decomen/NXP-K64-gateway/README.md

# 一、概述

   DM-MK64智能物联网关是蒂蒙技术基于NXP kinetis 平台开发的产品。它采用嵌入式RT-Thread实时操作系统。
是集成了模拟信号采集、开关量输入、开关量输出、计数和 无线数据通信于一体的高性能测控装置，可以直接接入各种传感器
标准变送器信号、仪表等输 出的模拟信号、电平信号、脉冲信号等，是实施无线测控的最佳选择。

1. 开放式软件架构设计：可以提供快速灵活的定制服务，适应不同客户需求。
2. 丰富的多样化接口：提供多种接口，便于本地实时数据分析和智能化处理。
3. 工业级标准设计：具备工业级标准设计，包括宽温、防尘、防刮、防静电以及抗强电磁干扰等特性，适用于各种严苛的工业场景。
4. 稳定可靠：累计出货量已超过万台，表现稳定可靠
# 二、典型应用

物联网关在众多场景中应用广泛，典型应用场景：

1. 智慧城市排水管理系统：通过监测排水管网的状态和水位，实现智能化的排水管理，提高城市排水系统的效率和可靠性。

2. 市政供热远程监控系统：实时监测供热设备的运行状态和能耗，远程控制供热系统，提高供热效率和节能减排。

3. 智慧工厂能耗监测系统：监测工厂各项设备的能耗情况，实现能源消耗的智能管理和优化，降低能源成本。

4. 市政燃气阀室控制系统：远程监控和控制燃气阀室设备，保障城市燃气供应的安全和稳定性。

5. ###### 电站配网管理系统：监测和管理电站配电网络的运行状态，实现电力分配的智能化和优化，提高电网的稳定性和安全性。

6. 楼宇电力监测控制系统：实时监测楼宇电力设备的运行状态和用电情况，实现对楼宇电力系统的智能化管理和控制。

7. 工业污水管理控制系统：监测工业污水处理设备的运行状态和水质参数，实现对工业污水处理过程的智能化控制和优化，保障环境水质安全。 

   # 三、特性和优势  

支持 4G LTE CAT4 高速网络和 LTE CAT1、 CATM 低速网络  

支持多种联网功能  

在线编程， 二次开发  

冗余设计， 保障设备网络通信不间断  

## 强大的安全功能

全工业化设计， 无惧恶劣条件的挑战； 外露接口全部做防雷击、 防浪
涌、 防静电处理， 支持1.5KV 隔离变压保护  

### 高可靠性设计  

智能防掉线， 支持在线检测， 在线维持， 掉线自动重拨， 确保设备永远在线

  FOTA  

支持OTA在线更新， 自动在线更新软件， 支持系统升级、 系统迭代， 无
需人员维护  

# 关于我们  

     深圳市蒂蒙技术有限公司是一家专注于工业物联网领域的高科技企业，自主研发了工业物联网平台产品AIoTOS和物联网边缘侧产品EdgeOS，为5G时代万物互联提供核心的底层物联技术。作为企业构建物联中台、园开发物联网AIOT行业应用的专业合作伙伴，我们在物联网底层技术的积累与拓展中，已完成多个行业AIOT应用，包括城市智慧大脑双碳系统、工业智慧能耗系统、智能水厂生产调度系统、智慧水务监测系统、智慧工业区系统等。

联系我们

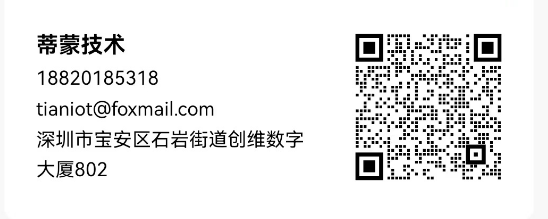
[picture p1: 小田.png]


解压密码:请扫描二维码跟客户获取。

## 目录说明

soft   源代码目录

image  烧写文件及相关工具

hardware  硬件设计源文件及生产文件

doc 相关使用文档

license.txt   BSD 3-Clause开源协议

NOTICE.md  开源声明文件

README.md   项目说明
