decomen/NXP-K64-gateway/hardware/ST-k60_coordinate.xlsx

PartType | RefDes | PartDecal | Pins | Layer | Orient. | X | Y | SMD | Glued
TESTPAD | +3V | TESET | 1 | Bottom | 0 | 31 | 98.5 | Yes | No
TESTPAD | +5V | TESET | 1 | Bottom | 0 | 19.4 | 105.4 | Yes | No
TESTPAD | +24V | TESET | 1 | Bottom | 0 | 15.2 | 2 | Yes | No
TESTPAD | -3V | TESET | 1 | Bottom | 0 | 31 | 103.5 | Yes | No
TESTPAD | -24V | TESET | 1 | Bottom | 0 | 22.8 | 2 | Yes | No
TESTPAD | 01+ | TESET | 1 | Bottom | 0 | 88.3 | 123 | Yes | No
TESTPAD | 01- | TESET | 1 | Bottom | 0 | 92.1 | 123 | Yes | No
TESTPAD | 1A | TESET | 1 | Bottom | 0 | 45.3 | 22 | Yes | No
TESTPAD | 1A_232_TX | TESET | 1 | Bottom | 0 | 47.9 | 26.8 | Yes | No
TESTPAD | 1A_485_TX | TESET | 1 | Bottom | 0 | 47.9 | 17.4 | Yes | No
TESTPAD | 1B | TESET | 1 | Bottom | 0 | 42.8 | 17.5 | Yes | No
TESTPAD | 1B_232_R | TESET | 1 | Bottom | 0 | 51.9 | 26.8 | Yes | No
TESTPAD | 1B_485_R | TESET | 1 | Bottom | 0 | 51.9 | 17.4 | Yes | No
TESTPAD | 01GND | TESET | 1 | Bottom | 0 | 54.855 | 2 | Yes | No
TESTPAD | 01RX | TESET | 1 | Bottom | 0 | 58.655 | 2 | Yes | No
TESTPAD | 01TX | TESET | 1 | Bottom | 0 | 51.045 | 2 | Yes | No
TESTPAD | 02+ | TESET | 1 | Bottom | 0 | 96 | 123 | Yes | No
TESTPAD | 02- | TESET | 1 | Bottom | 0 | 99.7 | 123 | Yes | No
TESTPAD | 2A | TESET | 1 | Bottom | 0 | 67.6 | 18.4 | Yes | No
TESTPAD | 2A_232_TX | TESET | 1 | Bottom | 0 | 55.6 | 26.8 | Yes | No
TESTPAD | 2A_485_TX | TESET | 1 | Bottom | 0 | 55.6 | 17.4 | Yes | No
TESTPAD | 2B | TESET | 1 | Bottom | 0 | 64 | 18.4 | Yes | No
TESTPAD | 2B_232_R | TESET | 1 | Bottom | 0 | 59.4 | 26.9 | Yes | No
TESTPAD | 2B_485_R | TESET | 1 | Bottom | 0 | 72.9 | 18.4 | Yes | No
TESTPAD | 02GND | TESET | 1 | Bottom | 0 | 66.285 | 2 | Yes | No
TESTPAD | 02RX | TESET | 1 | Bottom | 0 | 70.095 | 2 | Yes | No
TESTPAD | 02TX | TESET | 1 | Bottom | 0 | 62.475 | 2 | Yes | No
TESTPAD | 03+ | TESET | 1 | Bottom | 0 | 103.5 | 123 | Yes | No
TESTPAD | 03- | TESET | 1 | Bottom | 0 | 107.3 | 123 | Yes | No
TESTPAD | 3A | TESET | 1 | Bottom | 0 | 94.7 | 16 | Yes | No
TESTPAD | 03GND | TESET | 1 | Bottom | 0 | 77.715 | 2 | Yes | No
TESTPAD | 03RX | TESET | 1 | Bottom | 0 | 81.525 | 2 | Yes | No
TESTPAD | 03TX | TESET | 1 | Bottom | 0 | 73.905 | 2 | Yes | No
TESTPAD | 04+ | TESET | 1 | Bottom | 0 | 111.2 | 123 | Yes | No
TESTPAD | 04- | TESET | 1 | Bottom | 0 | 114.9 | 123 | Yes | No
TESTPAD | 4A | TESET | 1 | Bottom | 0 | 76.9 | 18.4 | Yes | No
TESTPAD | 04GND | TESET | 1 | Bottom | 0 | 89.145 | 2 | Yes | No
TESTPAD | 04RX | TESET | 1 | Bottom | 0 | 92.955 | 2 | Yes | No
TESTPAD | 04TX | TESET | 1 | Bottom | 0 | 85.335 | 2 | Yes | No
TESTPAD | 12V | TESET | 1 | Bottom | 0 | 155.6 | 106.6 | Yes | No
TESTPAD | 24+ | TESET | 1 | Bottom | 0 | 73 | 123 | Yes | No
TESTPAD | 24- | TESET | 1 | Bottom | 0 | 76.9 | 123 | Yes | No
TESTPAD | A | TESET | 1 | Bottom | 0 | 140.7 | 71.2 | Yes | No
TESTPAD | A1+ | TESET | 1 | Bottom | 0 | 120.8 | 22.1 | Yes | No
TESTPAD | A1- | TESET | 1 | Bottom | 0 | 121 | 15.2 | Yes | No
TESTPAD | A2+ | TESET | 1 | Bottom | 0 | 129 | 21.9 | Yes | No
TESTPAD | A2- | TESET | 1 | Bottom | 0 | 129 | 15.2 | Yes | No
TESTPAD | A3+ | TESET | 1 | Bottom | 0 | 136.7 | 21.8 | Yes | No
TESTPAD | A3- | TESET | 1 | Bottom | 0 | 136.8 | 15.1 | Yes | No
TESTPAD | A4+ | TESET | 1 | Bottom | 0 | 145 | 21.9 | Yes | No
TESTPAD | A4- | TESET | 1 | Bottom | 0 | 145 | 15.3 | Yes | No
TESTPAD | A5+ | TESET | 1 | Bottom | 0 | 161.5 | 22.9 | Yes | No
TESTPAD | A5- | TESET | 1 | Bottom | 0 | 152.8 | 20.6 | Yes | No
TESTPAD | A6+ | TESET | 1 | Bottom | 0 | 169.6 | 23.1 | Yes | No
TESTPAD | A6- | TESET | 1 | Bottom | 0 | 165.5 | 15.3 | Yes | No
TESTPAD | A7+ | TESET | 1 | Bottom | 0 | 177 | 22.8 | Yes | No
TESTPAD | A7- | TESET | 1 | Bottom | 0 | 173 | 15.3 | Yes | No
TESTPAD | A8+ | TESET | 1 | Bottom | 0 | 185 | 22.7 | Yes | No
TESTPAD | A8- | TESET | 1 | Bottom | 0 | 181 | 15.3 | Yes | No
TESTPAD | ADC-5V | TESET | 1 | Bottom | 0 | 150 | 45.7 | Yes | No
TESTPAD | ADC-9V | TESET | 1 | Bottom | 0 | 170.5 | 34.3 | Yes | No
TESTPAD | ADC-GND | TESET | 1 | Bottom | 0 | 145 | 45.7 | Yes | No
TESTPAD | ADC-GND1 | TESET | 1 | Bottom | 0 | 165.5 | 34.3 | Yes | No
TESTPAD | AI1+ | TESET | 1 | Bottom | 0 | 127.2 | 2 | Yes | No
TESTPAD | AI1- | TESET | 1 | Bottom | 0 | 123.4 | 2 | Yes | No
TESTPAD | AI2+ | TESET | 1 | Bottom | 0 | 134.8 | 2 | Yes | No
TESTPAD | AI2- | TESET | 1 | Bottom | 0 | 131 | 2 | Yes | No
TESTPAD | AI3+ | TESET | 1 | Bottom | 0 | 142.5 | 2 | Yes | No
TESTPAD | AI3- | TESET | 1 | Bottom | 0 | 138.6 | 2 | Yes | No
TESTPAD | AI4+ | TESET | 1 | Bottom | 0 | 150.1 | 2 | Yes | No
TESTPAD | AI4- | TESET | 1 | Bottom | 0 | 146.3 | 2 | Yes | No
TESTPAD | AI5+ | TESET | 1 | Bottom | 0 | 157.7 | 2 | Yes | No
TESTPAD | AI5- | TESET | 1 | Bottom | 0 | 153.9 | 2 | Yes | No
TESTPAD | AI6+ | TESET | 1 | Bottom | 0 | 165.3 | 2 | Yes | No
TESTPAD | AI6- | TESET | 1 | Bottom | 0 | 161.5 | 2 | Yes | No
TESTPAD | AI7+ | TESET | 1 | Bottom | 0 | 172.9 | 2 | Yes | No
TESTPAD | AI7- | TESET | 1 | Bottom | 0 | 169.2 | 2 | Yes | No
TESTPAD | AI8+ | TESET | 1 | Bottom | 0 | 180.6 | 2 | Yes | No
TESTPAD | AI8- | TESET | 1 | Bottom | 0 | 176.7 | 2 | Yes | No
TESTPAD | AT7 | TESET | 1 | Bottom | 0 | 67.6 | 45.8 | Yes | No
TESTPAD | AT8 | TESET | 1 | Bottom | 0 | 64 | 45.8 | Yes | No
KEY-2P-SMT | ATE | SW-334 | 4 | L1-Top | 270 | 1 | 51.9 | No | Yes
TESTPAD | B | TESET | 1 | Bottom | 0 | 133.7 | 71.2 | Yes | No
B0603_600_200MA_BLM18AG601SN1D_MURATA | B2 | CC0805 | 2 | L1-Top | 0 | 146.1 | 56.9 | Yes | No
CON-2P | BZ35 | CON-2P-2.0MM | 2 | L1-Top | 0 | 71 | 98.8 | No | No
CAP3 | C1 | EC-10 | 2 | L1-Top | 0 | 19 | 14 | No | No
CAP_NP | C2 | C0603 | 2 | L1-Top | 270 | 26 | 27.7 | Yes | No
CAP_NP | C3 | C0603 | 2 | L1-Top | 180 | 25.4 | 39.9 | Yes | No
CAP3 | C4 | CC0805 | 2 | L1-Top | 90 | 23.7 | 53.1 | Yes | No
CAP3 | C5 | CC0805 | 2 | L1-Top | 270 | 134.7 | 33.1 | Yes | No
CAP_NP | C6 | C0603 | 2 | L1-Top | 90 | 33.8 | 96.6 | Yes | No
CAP_NP | C7 | C0603 | 2 | L1-Top | 270 | 22.4 | 27.7 | Yes | No
C-DIP | C8 | CAP250VC | 2 | L1-Top | 90 | 3.5 | 37 | No | No
C0603_0.1UF50V_GRM188R71E104KA01D_MURATA | C9 | C0603 | 2 | L1-Top | 270 | 15.5 | 50.5 | Yes | No
CAP3 | C10 | CC0805 | 2 | L1-Top | 90 | 22.2 | 94.7 | Yes | No
CAP | C11 | C0603 | 2 | L1-Top | 90 | 22.2 | 91.2 | Yes | No
CAP3 | C12 | CC0805 | 2 | L1-Top | 270 | 33.8 | 93 | Yes | No
CAP_NP | C13 | C0603 | 2 | L1-Top | 270 | 35.7 | 93.1 | Yes | No
C-DIP | C14 | CAP250VC | 2 | L1-Top | 90 | 6.5 | 37 | No | No
RES-1/2W | C15 | R1/2W | 2 | L1-Top | 90 | 0.5 | 3 | No | No
CAP3 | C16 | CC0805 | 2 | L1-Top | 270 | 178.7 | 59.2 | Yes | No
CAP_NP | C17 | C0603 | 2 | L1-Top | 0 | 66.5 | 26.5 | Yes | No
CAP3 | C18 | CC0805 | 2 | L1-Top | 270 | 127.3 | 33.2 | Yes | No
CAP | C19 | C0603 | 2 | L1-Top | 90 | 64.3 | 53.3 | Yes | No
CAP_NP | C20 | C0603 | 2 | L1-Top | 0 | 167.1 | 28.7 | Yes | No
CAP3 | C21 | EC-7 | 2 | L1-Top | 90 | 70.9 | 47.5 | No | No
CAP3 | C22 | CC0805 | 2 | L1-Top | 90 | 60.2 | 50.2 | Yes | No
CAP_NP | C23 | C0603 | 2 | L1-Top | 270 | 60.2 | 46.6 | Yes | No
CAP3 | C24 | CC0805 | 2 | L1-Top | 270 | 62.8 | 43.6 | Yes | No
CAP_NP | C25 | C0603 | 2 | L1-Top | 270 | 65.1 | 43.8 | Yes | No
CAP_NP | C26 | C0603 | 2 | L1-Top | 0 | 136.8 | 74.8 | Yes | No
CAP | C27 | C0603 | 2 | L1-Top | 270 | 25.5 | 53.3 | Yes | No
CAP_NP | C28 | C0603 | 2 | L1-Top | 270 | 117.5 | 63.196 | Yes | No
CAP_NP | C29 | C0603 | 2 | L1-Top | 90 | 132.6 | 80.2 | Yes | No
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
CAP_NP | C198 | C0603 | 2 | L1-Top | 0 | 154.6 | 28.7 | Yes | No
CAP3 | C199 | CC0805 | 2 | L1-Top | 0 | 159.3 | 47.7 | Yes | No
CAP_NP | C206 | C0603 | 2 | L1-Top | 270 | 87.5 | 61.2 | Yes | No
CAP3 | C211 | CC0805 | 2 | L1-Top | 90 | 39 | 50.7 | Yes | No
TESTPAD | CLK | TESET | 1 | Bottom | 0 | 98.9 | 53.7 | Yes | No
CR-1220 | CR1 | CR1220 | 4 | L1-Top | 180 | 130.5 | 58.3 | No | No
BAT60A_H | D1 | 4148 | 2 | L1-Top | 90 | 48.6 | 51.3 | Yes | No
BC301N | D2 | 1812-BCXXXN-4.5X3.5X2.7MM | 2 | L1-Top | 270 | 7.5 | 4.5 | Yes | No
BF801M | D3 | BF801M | 2 | L1-Top | 0 | 2.5 | 43.5 | Yes | No
DIODE | D4 | SOD-323 | 2 | L1-Top | 180 | 129.6 | 71.6 | Yes | No
BAT60A_H | D5 | 4148 | 2 | L1-Top | 90 | 35.7 | 55 | Yes | No
BAT60A_H | D6 | 4148 | 2 | L1-Top | 90 | 42.1 | 55.1 | Yes | No
BAT60A_H | D7 | 4148 | 2 | L1-Top | 90 | 51.5 | 51.3 | Yes | No
BAT60A_H | D8 | 4148 | 2 | L1-Top | 90 | 54.6 | 49.6 | Yes | No
DIODE | D9 | SOD-323 | 2 | L1-Top | 270 | 101.6 | 45.9 | Yes | No
DIODE | D10 | SOD-323 | 2 | L1-Top | 270 | 103.6 | 45.9 | Yes | No
DIODE | D11 | SOD-323 | 2 | L1-Top | 270 | 122.9 | 99.5 | Yes | No
DIODE | D13 | SOD-323 | 2 | L1-Top | 180 | 134.1 | 42.6 | Yes | No
DIODE | D14 | SOD-323 | 2 | L1-Top | 180 | 141.6 | 42.6 | Yes | No
DIODE | D15 | SOD-323 | 2 | L1-Top | 180 | 148.8 | 42.5 | Yes | No
DIODE | D16 | SOD-323 | 2 | L1-Top | 180 | 156.2 | 42.6 | Yes | No
BAT60A_H | D17 | 4148 | 2 | L1-Top | 90 | 57.4 | 49.6 | Yes | No
BAT60A_H | D19 | 4148 | 2 | L1-Top | 180 | 37.5 | 31.5 | Yes | No
BAT60A_H | D20 | 4148 | 2 | L1-Top | 0 | 42.2 | 31.5 | Yes | No
DIODE | D22 | SOD-323 | 2 | L1-Top | 180 | 163.6 | 42.6 | Yes | No
DIODE | D23 | SOD-323 | 2 | L1-Top | 180 | 170.7 | 42.8 | Yes | No
DIODE | D24 | SOD-323 | 2 | L1-Top | 180 | 178.1 | 42.8 | Yes | No
BAT60A_H | D25 | 4148 | 2 | L1-Top | 0 | 124.8 | 67.8 | Yes | No
DIODE | D26 | SOD-323 | 2 | L1-Top | 180 | 185.5 | 42.9 | Yes | No
DIODE | D36 | SOD-323 | 2 | L1-Top | 180 | 70.8 | 95.9 | Yes | No
DIODE | D166 | SOD-323 | 2 | L1-Top | 270 | 96.9 | 101.4 | Yes | No
DIODE | D167 | SOD-323 | 2 | L1-Top | 0 | 104.9 | 95.7 | Yes | No
DIODE | D168 | SOD-323 | 2 | L1-Top | 0 | 111.9 | 95.6 | Yes | No
DIODE | D174 | SOD-323 | 2 | L1-Top | 270 | 69.4 | 113.6 | Yes | No
DIODE | D175 | SOD-323 | 2 | L1-Top | 270 | 89 | 114 | Yes | No
TESTPAD | DGND | TESET | 1 | Bottom | 0 | 94.7 | 56.2 | Yes | No
TESTPAD | DI1+ | TESET | 1 | Bottom | 0 | 123.425 | 116.5 | Yes | No
TESTPAD | DI1- | TESET | 1 | Bottom | 0 | 127.235 | 123 | Yes | No
TESTPAD | DI2+ | TESET | 1 | Bottom | 0 | 131.045 | 116.5 | Yes | No
TESTPAD | DI2- | TESET | 1 | Bottom | 0 | 134.855 | 123 | Yes | No
TESTPAD | DI3+ | TESET | 1 | Bottom | 0 | 138.7 | 116.5 | Yes | No
TESTPAD | DI3- | TESET | 1 | Bottom | 0 | 142.475 | 123 | Yes | No
TESTPAD | DI4+ | TESET | 1 | Bottom | 0 | 146.3 | 116.5 | Yes | No
TESTPAD | DI4- | TESET | 1 | Bottom | 0 | 150 | 123 | Yes | No
TESTPAD | DI5+ | TESET | 1 | Bottom | 0 | 154 | 116.5 | Yes | No
TESTPAD | DI5- | TESET | 1 | Bottom | 0 | 157.715 | 123 | Yes | No
TESTPAD | DI6+ | TESET | 1 | Bottom | 0 | 161.5 | 116.5 | Yes | No
TESTPAD | DI6- | TESET | 1 | Bottom | 0 | 165.335 | 123 | Yes | No
TESTPAD | DI7+ | TESET | 1 | Bottom | 0 | 169.3 | 116.5 | Yes | No
TESTPAD | DI7- | TESET | 1 | Bottom | 0 | 172.955 | 123 | Yes | No
TESTPAD | DI8+ | TESET | 1 | Bottom | 0 | 177 | 116.5 | Yes | No
TESTPAD | DI8- | TESET | 1 | Bottom | 0 | 180.575 | 123 | Yes | No
TESTPAD | DIO | TESET | 1 | Bottom | 0 | 94.8 | 51.2 | Yes | No
ESD | ESD1 | ESD | 2 | L1-Top | 90 | 11.5 | 4 | Yes | No
ESD | ESD2 | ESD | 2 | L1-Top | 90 | 70.1 | 2.6 | Yes | No
ESD | ESD3 | ESD | 2 | L1-Top | 90 | 62.5 | 2.6 | Yes | No
ESD | ESD4 | ESD | 2 | L1-Top | 90 | 58.7 | 2.6 | Yes | No
ESD | ESD5 | ESD | 2 | L1-Top | 90 | 51.1 | 2.6 | Yes | No
ESD | ESD6 | ESD | 2 | L1-Top | 90 | 93 | 2.7 | Yes | No
ESD | ESD7 | ESD | 2 | L1-Top | 90 | 85.3 | 2.6 | Yes | No
ESD | ESD8 | ESD | 2 | L1-Top | 90 | 81.6 | 2.6 | Yes | No
ESD | ESD9 | ESD | 2 | L1-Top | 90 | 73.9 | 2.6 | Yes | No
ESD | ESD50 | ESD | 2 | L1-Top | 270 | 127.2 | 2.4 | Yes | No
ESD | ESD51 | ESD | 2 | L1-Top | 270 | 134.85 | 2.4 | Yes | No
ESD | ESD52 | ESD | 2 | L1-Top | 270 | 142.5 | 2.4 | Yes | No
ESD | ESD53 | ESD | 2 | L1-Top | 270 | 150.15 | 2.4 | Yes | No
ESD | ESD54 | ESD | 2 | L1-Top | 90 | 123.45 | 2.4 | Yes | Yes
ESD | ESD55 | ESD | 2 | L1-Top | 90 | 131.1 | 2.4 | Yes | No
ESD | ESD56 | ESD | 2 | L1-Top | 90 | 138.75 | 2.4 | Yes | No
ESD | ESD57 | ESD | 2 | L1-Top | 90 | 146.25 | 2.4 | Yes | No
ESD | ESD58 | ESD | 2 | L1-Top | 270 | 157.65 | 2.4 | Yes | No
ESD | ESD59 | ESD | 2 | L1-Top | 270 | 165.3 | 2.4 | Yes | No
ESD | ESD60 | ESD | 2 | L1-Top | 270 | 172.95 | 2.4 | Yes | No
ESD | ESD61 | ESD | 2 | L1-Top | 270 | 180.6 | 2.4 | Yes | No
ESD | ESD62 | ESD | 2 | L1-Top | 90 | 153.9 | 2.4 | Yes | No
ESD | ESD63 | ESD | 2 | L1-Top | 90 | 161.55 | 2.4 | Yes | No
ESD | ESD64 | ESD | 2 | L1-Top | 90 | 169.2 | 2.4 | Yes | No
ESD | ESD65 | ESD | 2 | L1-Top | 90 | 176.7 | 2.4 | Yes | No
MINISMDC150 | F1 | MINISMDC150 | 2 | L1-Top | 270 | 10.5 | 29.5 | Yes | No
FU | F2 | CC0805 | 2 | L1-Top | 180 | 68.5 | 16 | Yes | No
FU | F3 | CC0805 | 2 | L1-Top | 180 | 65 | 16 | Yes | No
FU | F4 | CC0805 | 2 | L1-Top | 180 | 56 | 16 | Yes | No
FU | F5 | CC0805 | 2 | L1-Top | 180 | 47 | 16 | Yes | No
FU | F6 | CC0805 | 2 | L1-Top | 180 | 93.5 | 16 | Yes | No
FU | F7 | CC0805 | 2 | L1-Top | 180 | 84.5 | 16 | Yes | No
FUS | F8 | 2920 | 2 | L1-Top | 270 | 10.5 | 27 | Yes | No
FU | F9 | CC0805 | 2 | L1-Top | 180 | 72 | 16 | Yes | No
FU | F10 | 1206MIL | 2 | L1-Top | 90 | 72.1 | 113.6 | Yes | No
FU | F11 | 1206MIL | 2 | L1-Top | 90 | 81 | 113.6 | Yes | No
FU | F12 | CC0805 | 2 | L1-Top | 270 | 162.1 | 99.8 | Yes | No
FU | F13 | CC0805 | 2 | L1-Top | 180 | 81 | 16 | Yes | No
RES0603 | FS35 | RES0603 | 2 | L1-Top | 270 | 100.4 | 53.7 | Yes | No
TESTPAD | GND | TESET | 1 | Bottom | 0 | 15.4 | 105.4 | Yes | No
CON-3P-2.54MM | J1 | CON-3PIN-2.0MM | 3 | L1-Top | 90 | 164.4 | 108.9 | No | No
CON-3P-3.5MM | J2 | CON-3PIN-3.81MMA | 3 | L1-Top | 0 | 19 | 5.2 | No | Yes
CON-3P-2.54MM | J3 | CON-3PIN-2.0MM | 3 | L1-Top | 90 | 169.7 | 108.9 | No | No
DL | J4 | DL | 2 | L1-Top | 90 | 23.6 | 56.6 | Yes | No
DL | J5 | DL | 2 | L1-Top | 0 | 35.8 | 95.9 | Yes | No
CON-2P | J6 | CON-2P-2.0MM | 2 | L1-Top | 0 | 137.2 | 71.2 | No | No
CON-16P-3.81MM | J7 | CON-16PIN-3.81MM | 16 | L1-Top | 180 | 152 | 119.8 | No | Yes
CON-12P-3.81MM | J8 | CON-12PIN-3.81MM | 12 | L1-Top | 180 | 94 | 119.8 | No | Yes
CON-3P-2.54MM | J9 | CON-3PIN-2.0MM | 3 | L1-Top | 270 | 129.3 | 109.9 | No | No
CON-2P | J10 | CON-2P-2.0MM | 2 | L1-Top | 270 | 133 | 19 | No | No
CON-2P | J11 | CON-2P-2.0MM | 2 | L1-Top | 270 | 125 | 19 | No | No
CON-12P-3.81MM | J12 | CON-12PIN-3.81MM | 12 | L1-Top | 0 | 72 | 5.2 | No | Yes
DL | J13 | DL | 2 | L1-Top | 0 | 119.9 | 10.9 | Yes | No
DL | J14 | DL | 2 | L1-Top | 0 | 127.2 | 11 | Yes | No
DL | J15 | DL | 2 | L1-Top | 0 | 135 | 11 | Yes | No
DL | J16 | DL | 2 | L1-Top | 0 | 142.9 | 11 | Yes | No
DL | J17 | DL | 2 | L1-Top | 0 | 154 | 10.2 | Yes | No
DL | J18 | DL | 2 | L1-Top | 270 | 164.8 | 12.4 | Yes | No
DL | J19 | DL | 2 | L1-Top | 270 | 171.7 | 12.2 | Yes | No
DL | J21 | DL | 2 | L1-Top | 270 | 179.4 | 12.2 | Yes | No
CON-3P-2.54MM | J22 | CON-3PIN-2.0MM | 3 | L1-Top | 270 | 135.2 | 109.9 | No | No
CON-2P | J23 | CON-2P-2.0MM | 2 | L1-Top | 0 | 40.9 | 15.4 | No | No
CON-6P-2.54MM | J25 | BATTERY | 6 | L1-Top | 0 | -2 | 20 | No | Yes
CON-2P | J32 | CON-2P-2.0MM | 2 | L1-Top | 270 | 121 | 19 | No | No
CON-2P | J33 | CON-2P-2.0MM | 2 | L1-Top | 180 | 40.9 | 11.7 | No | No
CON-2P | J35 | CON-2P-2.0MM | 2 | L1-Top | 0 | 94.4 | 19 | No | No
SD_CARD_2 | J36 | SD | 14 | Bottom | 180 | 52.8 | 91.5 | No | Yes
RJ45-LED-PT | J37 | RJ45-LED-PT | 16 | L1-Top | 0 | 108 | 2.6 | No | No
CON-2P | J38 | CON-2P-2.0MM | 2 | L1-Top | 180 | 94.4 | 23.7 | No | No
CON-3P-2.54MM | J39 | CON-3PIN-2.0MM | 3 | L1-Top | 270 | 55.6 | 22.1 | No | No
CON-3P-2.54MM | J40 | CON-3PIN-2.0MM | 3 | L1-Top | 270 | 59.4 | 22.2 | No | No
CON-3P-2.54MM | J41 | CON-3PIN-2.0MM | 3 | L1-Top | 270 | 47.9 | 22.1 | No | No
CON-3P-2.54MM | J42 | CON-3PIN-2.0MM | 3 | L1-Top | 270 | 51.9 | 22.1 | No | No
CON-16P-3.81MM | J45 | CON-16PIN-3.81MM | 16 | L1-Top | 0 | 152 | 5.2 | No | Yes
DL | J49 | DL | 2 | L1-Top | 180 | 103.8 | 43 | Yes | No
CON-2P | J52 | CON-2P-2.0MM | 2 | L1-Top | 270 | 129 | 19 | No | No
CON-2P | J53 | CON-2P-2.0MM | 2 | L1-Top | 270 | 141 | 19 | No | No
CON-2P | J54 | CON-2P-2.0MM | 2 | L1-Top | 270 | 137 | 19 | No | No
CON-2P | J55 | CON-2P-2.0MM | 2 | L1-Top | 270 | 149 | 19 | No | No
CON-2P | J56 | CON-2P-2.0MM | 2 | L1-Top | 270 | 145 | 19 | No | No
CON-2P | J57 | CON-2P-2.0MM | 2 | L1-Top | 270 | 161.5 | 19 | No | No
CON-2P | J58 | CON-2P-2.0MM | 2 | L1-Top | 180 | 155.8 | 20.6 | No | No
CON-2P | J59 | CON-2P-2.0MM | 2 | L1-Top | 270 | 169 | 19 | No | No
CON-2P | J60 | CON-2P-2.0MM | 2 | L1-Top | 270 | 165.5 | 19 | No | No
CON-2P | J61 | CON-2P-2.0MM | 2 | L1-Top | 270 | 177 | 19 | No | No
CON-2P | J62 | CON-2P-2.0MM | 2 | L1-Top | 270 | 173 | 19 | No | No
CON-2P | J63 | CON-2P-2.0MM | 2 | L1-Top | 270 | 185 | 19 | No | No
CON-2P | J64 | CON-2P-2.0MM | 2 | L1-Top | 270 | 181 | 19 | No | No
CON-4PIN-2.54MM | JTAG | CON-4PIN-2.54MM | 4 | L1-Top | 270 | 96.7 | 52.5 | No | No
L-SMD-4P | L1 | L-SMD-4P | 4 | L1-Top | 0 | 18.5 | 23 | Yes | No
INDUCTOR | L2 | L-7X7X3.2MM | 2 | L1-Top | 0 | 25.1 | 46.2 | Yes | No
INDUCTOR1 | L3 | 0805 | 2 | L1-Top | 0 | 171.1 | 57.9 | Yes | No
INDUCTOR | L4 | L0805 | 2 | L1-Top | 180 | 109.2 | 42.7 | Yes | No
INDUCTOR | L5 | L0805 | 2 | L1-Top | 0 | 113.1 | 59.2 | Yes | No
INDUCTOR | L6 | L0805 | 2 | L1-Top | 270 | 119.5 | 39.9 | Yes | No
INDUCTOR | L7 | L0805 | 2 | L1-Top | 270 | 149.7 | 107.4 | Yes | No
INDUCTOR1 | L8 | 0805 | 2 | L1-Top | 180 | 23.6 | 56.6 | Yes | No
INDUCTOR1 | L9 | 0805 | 2 | L1-Top | 0 | 56.9 | 30.5 | Yes | No
INDUCTOR1 | L10 | 0805 | 2 | L1-Top | 0 | 167 | 62.3 | Yes | No
INDUCTOR1 | L11 | 0805 | 2 | L1-Top | 0 | 169.1 | 57.9 | Yes | No
INDUCTOR | L13 | L0805 | 2 | L1-Top | 0 | 118.8 | 5.4 | Yes | No
XC434 | L14 | SDCW2012A | 4 | L1-Top | 0 | 65.5 | 20 | Yes | No
XC434 | L15 | SDCW2012A | 4 | L1-Top | 0 | 86.9 | 20 | Yes | No
XC434 | L16 | SDCW2012A | 4 | L1-Top | 0 | 79.9 | 20 | Yes | No
INDUCTOR1 | L17 | 0805 | 2 | L1-Top | 0 | 93.7 | 40.8 | Yes | No
INDUCTOR1 | L18 | 0805 | 2 | L1-Top | 0 | 59 | 30.4 | Yes | No
INDUCTOR1 | L19 | 0805 | 2 | L1-Top | 0 | 54.2 | 30.4 | Yes | No
INDUCTOR1 | L20 | 0805 | 2 | L1-Top | 0 | 48.2 | 30.4 | Yes | No
INDUCTOR1 | L21 | 0805 | 2 | L1-Top | 0 | 91.5 | 40.8 | Yes | No
ER-081SG | L30 | ER-081SG | 8 | L1-Top | 270 | 39 | 40.8 | Yes | No
INDUCTOR1 | L38 | 0805 | 2 | L1-Top | 90 | 74.8 | 71 | Yes | No
INDUCTOR | L54 | L0805 | 2 | L1-Top | 0 | 173 | 53 | Yes | No
INDUCTOR1 | L112 | 0805 | 2 | L1-Top | 180 | 45.9 | 9.7 | Yes | No
XC434 | L127 | SDCW2012A | 4 | L1-Top | 0 | 72.4 | 20 | Yes | No
TLED | LED | TLED | 6 | L1-Top | 90 | 30.27 | 1 | No | Yes
MRK | MR1 | MRK | 1 | Bottom | 0 | 7 | 10 | Yes | No
MRK | MR2 | MRK | 1 | L1-Top | 0 | 7 | 10 | Yes | No
MRK | MR3 | MRK | 1 | L1-Top | 0 | 178.4 | 114.2 | Yes | No
MRK | MR4 | MRK | 1 | Bottom | 0 | 178.4 | 114.2 | Yes | No
VIA | P1 | VIA3.0MM | 9 | L1-Top | 0 | 7 | 16.1 | No | No
TESTPAD | PE-GND | TESET | 1 | Bottom | 0 | 19 | 2 | Yes | No
PMOS_1 | Q1 | SOP-8 | 8 | L1-Top | 180 | 19.2 | 55.6 | Yes | No
P-MOS | Q2 | SOT23 | 3 | L1-Top | 90 | 83.3 | 59.2 | Yes | No
2N3904_0 | Q3 | SOT23 | 3 | L1-Top | 0 | 72.4 | 56.5 | Yes | No
2N3904_0 | Q6 | SOT23 | 3 | L1-Top | 90 | 127.6 | 99.6 | Yes | No
2N3904_0 | Q7 | SOT23 | 3 | L1-Top | 270 | 165.4 | 86.8 | Yes | No
P-MOS-6 | Q9 | SOT-23-6 | 6 | L1-Top | 90 | 165.8 | 81.8 | Yes | No
2N3904_0 | Q12 | SOT23 | 3 | L1-Top | 270 | 74.3 | 38.3 | Yes | No
2N3904_0 | Q13 | SOT23 | 3 | L1-Top | 270 | 67 | 38.4 | Yes | No
2N3904_0 | Q16 | SOT23 | 3 | L1-Top | 90 | 88.4 | 58.1 | Yes | No
2N3904_0 | Q17 | SOT23 | 3 | L1-Top | 270 | 88.6 | 38.1 | Yes | No
2N3904_0 | Q19 | SOT23 | 3 | L1-Top | 270 | 81.2 | 38.2 | Yes | No
2N3906 | Q38 | SOT23 | 3 | L1-Top | 90 | 70.3 | 93.5 | Yes | No
2N3904_0 | Q39 | SOT23 | 3 | L1-Top | 90 | 77.1 | 93.5 | Yes | No
2N3904_0 | Q50 | SOT23 | 3 | L1-Top | 0 | 67.1 | 56.5 | Yes | No
2N3904_0 | Q166 | SOT23 | 3 | L1-Top | 0 | 94.2 | 104.6 | Yes | No
2N3904_0 | Q167 | SOT23 | 3 | L1-Top | 90 | 108.1 | 93.9 | Yes | No
2N3904_0 | Q168 | SOT23 | 3 | L1-Top | 90 | 115.7 | 94.8 | Yes | No
2N3904_0 | Q169 | SOT23 | 3 | L1-Top | 0 | 78.1 | 103.4 | Yes | No
2N3904_0 | Q170 | SOT23 | 3 | L1-Top | 0 | 87 | 103.3 | Yes | No
RES | R1 | R0603 | 2 | L1-Top | 90 | 29.4 | 27.6 | Yes | No
RES | R2 | R0603 | 2 | L1-Top | 90 | 24.2 | 27.7 | Yes | No
RES | R3 | R0603 | 2 | L1-Top | 90 | 18.8 | 31 | Yes | No
RES | R4 | R0603 | 2 | L1-Top | 180 | 22.2 | 39.9 | Yes | No
MOV14D15V | R5 | 1206MIL | 2 | L1-Top | 90 | 0.5 | 36.5 | Yes | No
RES | R6 | R0603 | 2 | L1-Top | 270 | 18.8 | 27.7 | Yes | No
MOV14D15V | R7 | 1206MIL | 2 | L1-Top | 90 | 10 | 36.5 | Yes | No
RES1 | R8 | R0603 | 2 | L1-Top | 90 | 13.7 | 47.2 | Yes | No
RES | R9 | R0603 | 2 | L1-Top | 90 | 20.6 | 27.7 | Yes | No
RES1 | R10 | R0603 | 2 | L1-Top | 270 | 13.7 | 44 | Yes | No
RES1 | R11 | R0603 | 2 | L1-Top | 270 | 15.5 | 53.7 | Yes | No
RES | R12 | R0603 | 2 | L1-Top | 0 | 4.2 | 69 | Yes | No
R0603 | R13 | R0603 | 2 | L1-Top | 0 | 129.8 | 79.2 | Yes | No
R0603 | R14 | R0603 | 2 | L1-Top | 90 | 134.5 | 80.2 | Yes | No
R0603 | R15 | R0603 | 2 | L1-Top | 270 | 136.3 | 80.2 | Yes | No
R0603 | R16 | R0603 | 2 | L1-Top | 90 | 123.3 | 73.7 | Yes | No
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
RES | R238 | R0603 | 2 | L1-Top | 90 | 184.8 | 24.7 | Yes | No
R0603 | R241 | R0603 | 2 | L1-Top | 90 | 123.3 | 77 | Yes | No
RES | R242 | R0603 | 2 | L1-Top | 270 | 127.2 | 87 | Yes | No
RES | R243 | R0603 | 2 | L1-Top | 90 | 181.3 | 24.7 | Yes | No
R0603_33_1%_ERJ-3GEYJ220V_PANASONIC | R246 | R0603 | 2 | L1-Top | 90 | 155 | 61.2 | Yes | No
RES | R248 | R0603 | 2 | L1-Top | 270 | 27.2 | 59.8 | Yes | No
RES | R250 | R0603 | 2 | L1-Top | 90 | 91.5 | 57.9 | Yes | No
RES | R251 | R0603 | 2 | L1-Top | 0 | 85 | 56.7 | Yes | No
RES | R252 | R0603 | 2 | L1-Top | 270 | 85.8 | 59 | Yes | No
RES | R253 | R0603 | 2 | L1-Top | 0 | 185.5 | 27 | Yes | No
RES | R254 | R0603 | 2 | L1-Top | 0 | 182.3 | 27 | Yes | No
RES | R255 | R0603 | 2 | L1-Top | 180 | 185.3 | 40.9 | Yes | No
RES | R256 | R0603 | 2 | L1-Top | 180 | 182.2 | 40.9 | Yes | No
RES | R257 | R0603 | 2 | L1-Top | 180 | 185.3 | 39.2 | Yes | No
R-1206 | R258 | R-1206 | 2 | L1-Top | 90 | 184.5 | 12.5 | Yes | No
R-1206 | R259 | R-1206 | 2 | L1-Top | 90 | 181.5 | 12.5 | Yes | No
R0603 | R260 | R0603 | 2 | L1-Top | 270 | 64.3 | 56.4 | Yes | No
R0603 | R261 | R0603 | 2 | L1-Top | 270 | 66.2 | 53.4 | Yes | No
R0603 | R262 | R0603 | 2 | L1-Top | 270 | 64 | 69.5 | Yes | No
R0603 | R263 | R0603 | 2 | L1-Top | 90 | 68 | 53.4 | Yes | No
R0603 | R266 | R0603 | 2 | L1-Top | 270 | 69.8 | 56.5 | Yes | No
RES | R268 | R0603 | 2 | L1-Top | 270 | 100.5 | 93.2 | Yes | No
RES | R269 | R0603 | 2 | L1-Top | 270 | 85.5 | 93.3 | Yes | No
R0603_33_1%_ERJ-3GEYJ220V_PANASONIC | R270 | R0603 | 2 | L1-Top | 90 | 151.3 | 61.2 | Yes | No
R0603_33_1%_ERJ-3GEYJ220V_PANASONIC | R271 | R0603 | 2 | L1-Top | 90 | 156.8 | 61.2 | Yes | No
RES | R281 | R0603 | 2 | L1-Top | 0 | 165.4 | 84.3 | Yes | No
RES | R282 | R0603 | 2 | L1-Top | 180 | 162.2 | 84.3 | Yes | No
R0603 | R284 | R0603 | 2 | L1-Top | 270 | 73.2 | 53.4 | Yes | No
R0603 | R285 | R0603 | 2 | L1-Top | 270 | 69.7 | 69.5 | Yes | No
R0603 | R286 | R0603 | 2 | L1-Top | 90 | 71.5 | 53.4 | Yes | No
KEY-2P-SMT | RESET1 | SW-334 | 4 | L1-Top | 0 | 39.5 | 4 | No | Yes
DIODE_TVS_BIDIR | S7 | SOD-323 | 2 | L1-Top | 270 | 52.3 | 30.3 | Yes | No
DIODE_TVS_BIDIR | S8 | SOD-323 | 2 | L1-Top | 270 | 50.4 | 30.3 | Yes | No
DIODE_TVS_BIDIR | S9 | SOD-323 | 2 | L1-Top | 180 | 56.2 | 33.1 | Yes | No
DIODE_TVS_BIDIR | S10 | SOD-323 | 2 | L1-Top | 0 | 59.8 | 33.1 | Yes | No
RELAY | SC1 | PA-RELAY | 4 | L1-Top | 90 | 117.9 | 105.8 | No | No
RELAY | SC166 | PA-RELAY | 4 | L1-Top | 90 | 100.3 | 105.7 | No | No
RELAY | SC167 | PA-RELAY | 4 | L1-Top | 90 | 106.1 | 105.7 | No | No
RELAY | SC168 | PA-RELAY | 4 | L1-Top | 90 | 112.1 | 105.7 | No | No
AQY212EH | SC169 | AQY212EH | 4 | L1-Top | 90 | 76.7 | 111.6 | Yes | No
AQY212EH | SC170 | AQY212EH | 4 | L1-Top | 90 | 85.5 | 111.6 | Yes | No
P0080SC | T1 | SMB-DO-214AA | 2 | L1-Top | 90 | 68 | 10.8 | Yes | No
P0080SC | T2 | SMB-DO-214AA | 2 | L1-Top | 90 | 62.5 | 10.8 | Yes | No
P0080SC | T3 | SMB-DO-214AA | 2 | L1-Top | 90 | 56 | 10.7 | Yes | No
P0080SC | T4 | SMB-DO-214AA | 2 | L1-Top | 90 | 51 | 10.7 | Yes | No
P0080SC | T5 | SMB-DO-214AA | 2 | L1-Top | 90 | 92.4 | 10.9 | Yes | No
P0080SC | T6 | SMB-DO-214AA | 2 | L1-Top | 90 | 87.5 | 10.9 | Yes | No
P0080SC | T7 | SMB-DO-214AA | 2 | L1-Top | 90 | 79.5 | 10.9 | Yes | No
P0080SC | T8 | SMB-DO-214AA | 2 | L1-Top | 90 | 74.7 | 10.9 | Yes | No
P0080SC | T9 | SMB-DO-214AA | 2 | L1-Top | 90 | 115.6 | 19.6 | Yes | No
P0080SC | T10 | SMB-DO-214AA | 2 | L1-Top | 90 | 110.4 | 19.6 | Yes | No
P0080SC | T11 | SMB-DO-214AA | 2 | L1-Top | 90 | 105.4 | 19.6 | Yes | No
P0080SC | T12 | SMB-DO-214AA | 2 | L1-Top | 90 | 100.4 | 19.6 | Yes | No
H1102 | T201 | H1102 | 16 | L1-Top | 180 | 115 | 38.1 | Yes | No
TESTPAD | TTL1 | TESET | 1 | Bottom | 0 | 80.7 | 123 | Yes | No
TESTPAD | TTL2 | TESET | 1 | Bottom | 0 | 84.5 | 123 | Yes | No
DIODE_TVS_BIDIR | TVS2 | SOD-323 | 2 | L1-Top | 270 | 62.6 | 21.8 | Yes | No
DIODE_TVS_BIDIR | TVS3 | SOD-323 | 2 | L1-Top | 270 | 68 | 21.8 | Yes | No
DIODE_TVS_BIDIR | TVS4 | SOD-323 | 2 | L1-Top | 180 | 65.3 | 23.3 | Yes | No
DIODE_TVS_BIDIR | TVS5 | SOD-323 | 2 | L1-Top | 270 | 84.3 | 22 | Yes | No
DIODE_TVS_BIDIR | TVS6 | SOD-323 | 2 | L1-Top | 270 | 89.5 | 22 | Yes | No
DIODE_TVS_BIDIR | TVS7 | SOD-323 | 2 | L1-Top | 180 | 86.8 | 23.3 | Yes | No
DIODE_TVS_BIDIR | TVS8 | SOD-323 | 2 | L1-Top | 270 | 77 | 21.9 | Yes | No
DIODE_TVS_BIDIR | TVS10 | SOD-323 | 2 | L1-Top | 270 | 82.2 | 22 | Yes | No
DIODE_TVS_BIDIR | TVS11 | SOD-323 | 2 | L1-Top | 180 | 79.6 | 23.3 | Yes | No
DIODE_TVS_BIDIR | TVS124 | SOD-323 | 2 | L1-Top | 270 | 75 | 21.9 | Yes | No
DIODE_TVS_BIDIR | TVS127 | SOD-323 | 2 | L1-Top | 270 | 69.8 | 21.8 | Yes | No
DIODE_TVS_BIDIR | TVS128 | SOD-323 | 2 | L1-Top | 180 | 72.4 | 23.3 | Yes | No
RT7272B | U1 | SOP-8A | 9 | L1-Top | 180 | 24.1 | 34.2 | Yes | No
TL431 | U2 | SOT89 | 3 | L1-Top | 270 | 8.9 | 47.3 | Yes | No
AM1117-3.3V | U3 | SOT223 | 4 | L1-Top | 270 | 27.9 | 94.2 | Yes | No
UA258 | U4 | SOP-8 | 8 | L1-Top | 180 | 9.9 | 55.5 | Yes | No
B0505M-1W | U5 | B0505M-1W | 4 | L1-Top | 0 | 31.5 | 14 | No | No
XC6XXX-89 | U6 | SOT89 | 3 | L1-Top | 90 | 65 | 48.3 | Yes | No
SN74LVC1G04 | U7 | SOT25-2 | 5 | L1-Top | 180 | 130.1 | 82.7 | Yes | No
AM1117-3.3V | U8 | SOT223 | 4 | L1-Top | 270 | 16.5 | 94.2 | Yes | No
LM358 | U9 | SOP-8 | 8 | L1-Top | 0 | 138.4 | 33.9 | Yes | No
KSZ8081RNACA | U10 | QFN-32PIN-4X4MM | 25 | L1-Top | 90 | 113.6 | 49.3 | Yes | No
MAX813L | U11 | SOP-8 | 8 | L1-Top | 90 | 129.7 | 75.4 | Yes | No
B0524-1W | U12 | B0524-1W | 4 | L1-Top | 0 | 168.7 | 70.2 | No | No
OPTOISO1 | U13 | LTV357 | 4 | L1-Top | 90 | 71 | 62.9 | Yes | No
SP485 | U14 | SOP-8 | 8 | L1-Top | 180 | 64.8 | 32.2 | Yes | No
SP485 | U15 | SOP-8 | 8 | L1-Top | 180 | 86.8 | 31.8 | Yes | No
SP485 | U16 | SOP-8 | 8 | L1-Top | 180 | 79.5 | 31.8 | Yes | No
RT9077-90 | U17 | SOT25-2 | 5 | L1-Top | 0 | 184.9 | 64.4 | Yes | No
TTL-RF | U18 | TTL-RF | 12 | L1-Top | 180 | 161.5 | 115.5 | No | No
XC6XXX-89 | U19 | SOT89 | 3 | L1-Top | 0 | 175 | 60.6 | Yes | No
LM358 | U20 | SOP-8 | 8 | L1-Top | 0 | 145.7 | 33.8 | Yes | No
LM358 | U21 | SOP-8 | 8 | L1-Top | 0 | 153.1 | 33.7 | Yes | No
TTL-RF | U22 | TTL-RF | 12 | L1-Top | 180 | 186 | 103 | No | No
SPI-SRAM | U23 | SOP-8 | 8 | L1-Top | 90 | 121 | 83.1 | Yes | No
LM358 | U24 | SOP-8 | 8 | L1-Top | 0 | 160.7 | 33.7 | Yes | No
LM358 | U26 | SOP-8 | 8 | L1-Top | 0 | 168.3 | 33.6 | Yes | No
LM358 | U27 | SOP-8 | 8 | L1-Top | 0 | 176 | 33.6 | Yes | No
LM358 | U28 | SOP-8 | 8 | L1-Top | 0 | 183.5 | 33.5 | Yes | No
IC_AD7689_8CH16B250K_ADC_ADI | U29 | AD7689 | 21 | L1-Top | 90 | 154.9 | 52.3 | Yes | No
RTU-EXPANSION | U30 | RTU_EXPANSION | 48 | L1-Top | 0 | -2 | 75 | No | No
K60_144P | U36 | LQFP-144PIN-22X22MM | 144 | L1-Top | 0 | 95 | 77 | Yes | No
SOP-8 | U37 | TQFN-8 | 8 | L1-Top | 0 | 119.8 | 89.7 | Yes | No
SN6501 | U38 | SOT25-2 | 5 | L1-Top | 180 | 38.8 | 56.2 | Yes | No
LM358 | U52 | SOP-8 | 8 | L1-Top | 0 | 130.8 | 34 | Yes | No
REF19X | U56 | SOP-8 | 8 | L1-Top | 180 | 169 | 50.5 | Yes | No
OPTOISO1 | U58 | LTV357 | 4 | L1-Top | 90 | 65 | 62.9 | Yes | No
ADUM1411 | U59 | SOIC127P1030X265-16N | 16 | L1-Top | 270 | 154 | 73 | Yes | No
NUP4301 | U63 | TSOP-6 | 6 | L1-Top | 0 | 113.9 | 42.5 | Yes | No
SP232E | U115 | SO16NB | 16 | L1-Top | 0 | 52.8 | 40.6 | Yes | No
SP485 | U120 | SOP-8 | 8 | L1-Top | 180 | 72.3 | 31.8 | Yes | No
ADUM1402 | U124 | SOIC127P1030X265-16N | 16 | L1-Top | 270 | 54.7 | 62.6 | Yes | No
ADUM1402 | U125 | SOIC127P1030X265-16N | 16 | L1-Top | 270 | 84.7 | 46.7 | Yes | No
TESTPAD | VCC | TESET | 1 | Bottom | 0 | 124.5 | 110.9 | Yes | No
TESTPAD | VCC1 | TESET | 1 | Bottom | 0 | 177.4 | 97.2 | Yes | No
TESTPAD | VCC2 | TESET | 1 | Bottom | 0 | 167 | 108.9 | Yes | No
TESTPAD | VCC_DET | TESET | 1 | Bottom | 0 | 96.7 | 46.6 | Yes | No
CRYSTAL_JXS63 | Y1 | OSC-49S | 4 | L1-Top | 90 | 123.8 | 45.8 | Yes | No
OSC-32.768K | Y2 | OSC-49S | 4 | L1-Top | 180 | 115.9 | 67 | Yes | No
OSC-32.768K | Y36 | OSC-49S | 4 | L1-Top | 0 | 79.3 | 63 | Yes | No
