decomen/NXP-K64-gateway/hardware/ST-k60_BOM.xlsx

K60_4.0 2017/12/19 565套
Index | Part Number | Description | Decal | QTY | Name | Remarks
1 | SPI SRAM | 23LCV1024 | SOP-8 | 1 | U23 | NC
2 | 电源模块 | ZME1205S/D | ZME1205-1W | 1 | U5 | NC
8 | 电源模块 | ZM2H1212SA/DA | ZM2H1212-2W | 1 | U12
3 | 通信模块排座 | 扩展模块 | 双排24PINX2/2.0MM | 2 | U30
4 | 输入模块 | 输入模块 | TTL-RF | 2 | U18 U22
5 | 模数转换器 | AD7689BCPZ | QFN-20 | 1 | U29
6 | 磁耦芯片 | ADUM1411ARWZ | SOIC-16N | 1 | U59
7 | 磁耦芯片 | ADUM1412ARWZ/ISO7242CDWR | SOIC-16N | 2 | U124 U125
8 | 普通光耦 | LTV-357T-C | LTV357 | 2 | U13 U58
9 | 网口芯片 | KSZ8081RNACA | QFN-32PIN | 1 | U10
10 | 双运放 | LM358 | SOP-8 | 1 | U4 | NC
11 | 双运放 | TP2272-SR | SOP-8 | 8 | U9 U20 U21 U24 U26 U27 U28 U52
12 | 主控芯片 | MK64FN1M0VLQ12 | LQFP-144 | 1 | U36
13 | 微控芯片 | SP706REN | SOP-8 | 1 | U11
14 | 基准芯片 | REF195GSZ-REEL7 | SOP-8 | 1 | U56
15 | ESD芯片 | NUP4301MR6T1G | TSOP-6 | 1 | U63
16 | 存储芯片 | W25Q256FVEM | WSON-8 | 1 | U37
17 | 电源芯片 | RT7272BGSP | SOP-8 | 1 | U1
18 |  | RT9161A-50PX | SOT89 | 2 | U6 U19
19 |  | NCP1117ST33T3G | SOT223 | 1 | U3
 |  | NCP1117ST50T3G | SOT223 | 1 | U8
20 |  | SPX3819M5-ADJ | SOT25-2 | 1 | U17
21 | 可控精密稳压源 | TL431 | SOT89 | 0 | U2 | NC
22 | 单路反向器 | SN74LVC1G04 | SOT23-5 | 0 | U7 | NC
 | 震荡芯片 | SN6501DBVR | SOT23-5 | 1 | U38
23 | 通信芯片 | SP232EEN-L/TR | SO16NB | 1 | U115
24 |  | BL3085N | SOP-8 | 4 | U14 U15 U16 U120
25 | 普通二极管 | 1N4148WS-7-F | SOD-323 | 17 | D4 D9 D10 D13 D14 D15 D16 D22 D23 D24 D26 D11 D166 D167 D168 D174 D175
26 | 普通二极管 | 1N5819HW-7-F | SOD-123 | 9 | D1 D5 D6 D7 D8 D17 D19 D20 D25
27 | P-MOS管 | AO4407 | SOP-8 | 0 | Q1 | NC
28 |  | AO6405 | SOT-23-6 | 1 | Q9
29 |  | Si2399DS-T1-GE3 | SOT23 | 1 | Q2
30 | NPN三极管 | MMBT3904LT1G | SOT23 | 14 | Q3 Q6 Q7 Q12 Q13 Q16 Q17 Q19 Q50 Q166 Q167 Q168 Q169 Q170
31 | SD卡 | AXA2R73061 | SD | 1 | J36
32 | 有源晶体 | 25MHZ | 5032 | 1 | Y2
33 | 有源晶体 | 32.768K/有源晶体 | 5032 | 1 | Y36
34 | 电池座 | 纽扣电池座 | CR1220 | 1 | CR1
35 | 气体放电管 | BF801M/SG5042B800 | 1812 | 1 | D3
36 |  | SMD301X/SMD300XM | 1812 | 1 | D2
37 | 半导体放电管 | SELC15CI | SOD-323 | 4 | S7 S8 S9 S10
38 |  | SELC08CI | SOD-323 | 12 | TVS2 TVS3 TVS4 TVS5 TVS6 TVS7 TVS8 TVS10 TVS11 TVS124 TVS127 TVS128
39 |  | P0300SC | SMB-DO-214AA | 8 | T1 T2 T3 T4 T5 T6 T7 T8
40 |  | P4200SC | SMB-DO-214AA | 4 | T9 T10 T11 T12
41 | 磁珠 | CBW201209U101T | 0805 | 13 | L3 L4 L5 L6 L7 L10 L11 L17 L21 L38 L54 L112 B2 | L8(NC)
42 |  | CBW201209U121T | 0805 | 4 | L9 L18 L19 L20
43 | 自恢复保险丝 | Z-MSMD110 | 1812 | 1 | F1
44 |  | MF-PSMF010X-2 | 0805 | 9 | F2 F3 F4 F5 F6 F7 F9 F13 F12
45 |  | MF-NSMF050-2 | 1206 | 2 | F10 F11
47 | 共模电感 | ILS0405-01 | SMD-4 | 1 | L1
48 |  | WCM-3216-222T | SOD-4 | 4 | L14 L15 L16 L127
49 | 功率电感 | SLF7045T-100M1R0-PF | 7X7MM | 1 | L2
50 | 隔离电感 | ER-081SG | 10X10MM | 1 | L30
51 | 压敏电阻 | KRMV1206G330NXT | 1206 | 2 | R5 R7 | R172(NC)
52 | 网络变压器 | H1601G | SOIC-16 | 1 | T201
53 | 贴片电阻 | 0R | R0603 | 4 | R45 R147 R148 FS35
53 | 贴片电阻 | 22R | R0603 | 24 | R12 R31 R32 R33 R34 R35 R36 R37 R38 R39 R58 R59 R60 R61 R62 R63 R64 R79 R155 R221 R228 R246 R270 R271
54 | 贴片电阻 | 49.9R | R0603 | 8 | R65 R66 R96 R140 R141 R144 R145 R146
55 | 贴片电阻 | 75R | R0603 | 4 | R125 R128 R129 R130
56 | 圆柱贴片电阻 | 100R | 1206 | 16 | R19 R24 R103 R136 R180 R182 R190 R191 R199 R200 R208 R214 R236 R237 R258 R259
57 | 贴片电阻 | 120R | 1206 | 4 | R104 R105 R106 R107 | R26(NC)
58 | 贴片电阻 | 100R | R0603 | 4 | R150 R167 R169 R171
60 | 贴片电阻 | 330R | R0603 | 13 | R17 R69 R70 R102 R134 R152 R154 R158 R159 R160 R161 R173 R176
61 | 贴片电阻 | 715R | R0603 | 8 | R68 R98 R108 R109 R113 R114 R123 R126
62 | 贴片电阻 | 1K | R0603 | 15 | R51 R100 R111 R116 R266 R260 R261 R282 R284 R174 R177 R151 R166 R168 R170
63 | 贴片电阻 | 3.3K | R0603 | 5 | R6 R16 R20 R138 R250
64 | 贴片电阻 | 6.49K | R0603 | 1 | R44
65 | 贴片电阻 | 10K | R0603 | 28 | R11 R27 R28 R42 R43 R48 R54 R55 R56 R57 R67 R72 R73 R76 R90 R95 R101 R112 R119 R124 R132 R156 R251 R262 R268 R269 R285 | R14(NC)
66 | 贴片电阻 | 13K | R0603 | 0 |  | R10(NC)
67 | 贴片电阻 | 15K | R0603 | 2 | R4 R122
68 | 贴片电阻 | 18K | R0603 | 0 |  | R8(NC)
69 | 贴片电阻 | 20K | R0603 | 8 | R52 R120 R175 R187 R196 R205 R233 R255
70 | 贴片电阻 | 30K | R0603 | 48 | R29 R30 R41 R47 R49 R50 R53 R92 R93 R97 R121 R131 R137 R139 R149 R153 R178 R179 R183 R184 R185 R186 R188 R189 R192 R193 R194 R195 R197 R198 R201 R202 R203 R204 R206 R207 R222 R230 R231 R232 R234 R235 R238 R243 R253 R254 R256 R257
71 | 贴片电阻 | 33K | R0603 | 1 | R9
72 | 贴片电阻 | 47K | R0603 | 4 | R3 R21 R18 R94
73 | 贴片电阻 | 56K | R0603 | 0 | R13 | R13(NC)
74 | 贴片电阻 | 84.5K | R0603 | 2 | R1 R2 R15 | R15(NC)
75 | 贴片电阻 | 100K | R0603 | 31 | R46 R91 R99 R110 R115 R118 R162 R163 R164 R165 R181 R209 R210 R211 R212 R213 R215 R216 R217 R218 R219 R220 R252 R263 R281 R286 R223 R224 R225 R226 R227
76 | 贴片电容 | 8.2pF | C0603 | 16 | C20 C131 C143 C160 C174 C175 C178 C179 C180 C181 C186 C187 C190 C191 C192 C193
77 | 贴片电容 | 47pF | C0603 | 12 | C17 C78 C99 C100 C103 C104 C119 C120 C122 C123 C140 C141
78 | 贴片电容 | 100pF | C0603 | 4 | C51 C53 C54 C56
79 | 贴片电容 | 1nF | C0603 | 17 | C45 C110 C114 C126 C134 C172 C173 C176 C177 C182 C183 C184 C185 C188 C189 C194 C198
80 | 贴片电容 | 2.7nF | C0603 | 1 | C7
81 | 贴片电容 | 6.8nF | C0603 | 8 | C135 C136 C156 C157 C158 C159 C162 C163
82 | 贴片电容 | 100nF | C0603 | 68 | C2 C3 C9 C13 C19 C23 C25 C26 C27 C28 C32 C38 C39 C40 C46 C50 C52 C55 C59 C61 C62 C63 C64 C66 C67 C68 C69 C70 C71 C72 C73 C74 C77 C79 C80 C89 C98 C101 C105 C106 C108 C109 C111 C115 C117 C124 C127 C132 C137 C139 C144 C146 C147 C148 C149 C152 C153 C154 C155 C164 C165 C166 C167 C168 C169 C196 C206 | C29(NC)
83 | 贴片电容 | 1uF | C0603 | 6 | C49 C58 C113 C116 C118 C121
84 | 贴片电容 | 22uF | CC0805 | 23 | C4 C5 C12 C22 C24 C31 C34 C37 C42 C43 C48 C65 C75 C102 C125 C133 C138 C145 C151 C170 C171 C199 C211
85 | 插件电容 | 1UF/2KV | 10MM | 0 | C15 | NC
86 | 插件电容 | 470uF/50V | EC-10 | 1 | C1
87 | 插件电容 | 220uF/16V | EC-10 | 1 | C76 | NC
88 | 插件灯座 | 灯座 | 灯座 | 1 | LED
89 | 端子 | 3PIN | 3.81MM | 1 | J2
90 | 端子 | 12PIN | 3.81MM | 2 | J8 J12
91 | 端子 | 16PIN | 3.81MM | 2 | J7 J45
92 | 排针 | 2PIN | 2.0MM | 21 | J6 J10 J11 J23 J32 J33 J35 J38 J52 J53 J54 J55 J56 J57 J58 J59 J60 J61 J62 J63 J64
93 | 排针 | 3PIN | 2.0MM | 6 | J9 J22 J39 J40 J41 J42 | J1(NC) J3(NC)
94 | 网口座 | RJ-45 | RJ45-LED-PT | 1 | J37
95 | 插件电容 | 1nF/2KV | 5MM | 6 | C8 C14 C33 C47 C129 C150
96 | 机械继电器 | HF49FD | PA-RELAY | 4 | SC1 SC166 SC167 SC168
97 | 固态继电器 | AQY212EH | AQY212EH | 2 | SC169 SC170
98 | 开关 | 轻触开关 | SW-334 | 2 | ATE RESET1
装配物料
1 | 螺丝 | M3 | 平头（外壳） | 5
2 | 螺丝 | M4 | 盖帽（主板） | 6+(3) | 扩展模块用量3PCS
3 | IPX转接线(ZigBee） | SMA母头母针/1.13线材/IPEX端/130MM/带帽 |  | 1 | 预估备货（库存200条）
4 | IPX转接线（GSM) | SMA母头母针/1.13线材/IPEX端/200MM/带帽 |  | 1 | 预估备货（库存200条）
5 | 插销式配线固定座 | 理线夹 线卡 尼龙环保材料 |  | 2
6 | 碳带 | 标签纸用碳带 |  | 2 | 60x40MM
7 | 贴纸 | SN贴纸（设备ID号） |  | 1 | 50X10MM
11 | 贴纸 | 设备PN码贴纸 |  | 1 | 50x30MM
8 | 电池 | CR1220纽扣电池 |  | 1 | 直径：13MM
9 | 跳帽 | 2PIN | 2.0MM | 13
10 | 铜柱 | 单头六角铜柱:M3X8+6MM |  | 3
包装物料
1 | 导轨 | 导轨 |  | 1
2 | 面膜 | 面膜前后一套（两片） |  | 1
3 | 干燥剂 | 干燥剂 |  | 1 | 5克
4 | 密封袋 | 设备包装袋 |  | 1 | 300X200MM
5 | 合格证 | 合格证 |  | 1
6 | 端子 | 3PIN/公头/绿 | 3.81MM | 1
7 | 端子 | 12PIN/公头/绿 | 3.81MM | 2
8 | 端子 | 16PIN/公头/绿 | 3.81MM | 2
9 | GSM天线 | 3DB | 全向天线增益天线内针 | 1
10 | 2.4G天线 | 3DB | 全向天线增益天线内针 | 1
11 | 飞机盒 | 23X17.5X7.5 | K9K60X58 | 1
12 | 珍珠棉 | 170X75X40MM |  | 1
13 | 标签纸 | 纸箱：80X50MM |  | 1
14 | 纸箱 | 42X25X37X | K=A158x62 | 1
96 | 扩展板 | 电池板扩展 | BATTERY | 1 | J25 | NC
97 | 插座 | 2PIN | 2.MM | 1 | BZ35 | NC
99 | 排针 | 4PIN | 2.54MM | 1 | JTAG | NC
101 | 无源源晶体 | NC | 5032 | 1 | Y1 | NC
102 | 自恢复保险丝 | NC | 2920 | 1 | F8 | NC
103 | 三极管 | NC | SOT23 | 2 | Q38 Q39 | NC
104 | 普通二极管 | NC | SOD-323 | 1 | D36 | NC
105 | 贴片电容 | NC | C0603 | 8 | C6 C11 C30 C35 C36 C41 C60 C166 | NC
106 | 贴片电容 | NC | CC0805 | 8 | C10 C16 C18 C44 C57 C112 C128 C142 | NC
107 | 磁珠 | NC | L0805 | 1 | L13 | NC
108 | 贴片电阻 | NC | R0603 | 11 | R25 R40 R71 R75 R77 R78 R117 R229 R241 R242 R248 | NC
109 | 插件电容 | 100UF/10V | EC-5 | 1 | C21 | NC
