decomen/NXP-K64-gateway/hardware/ST-K60_Logic.pdf

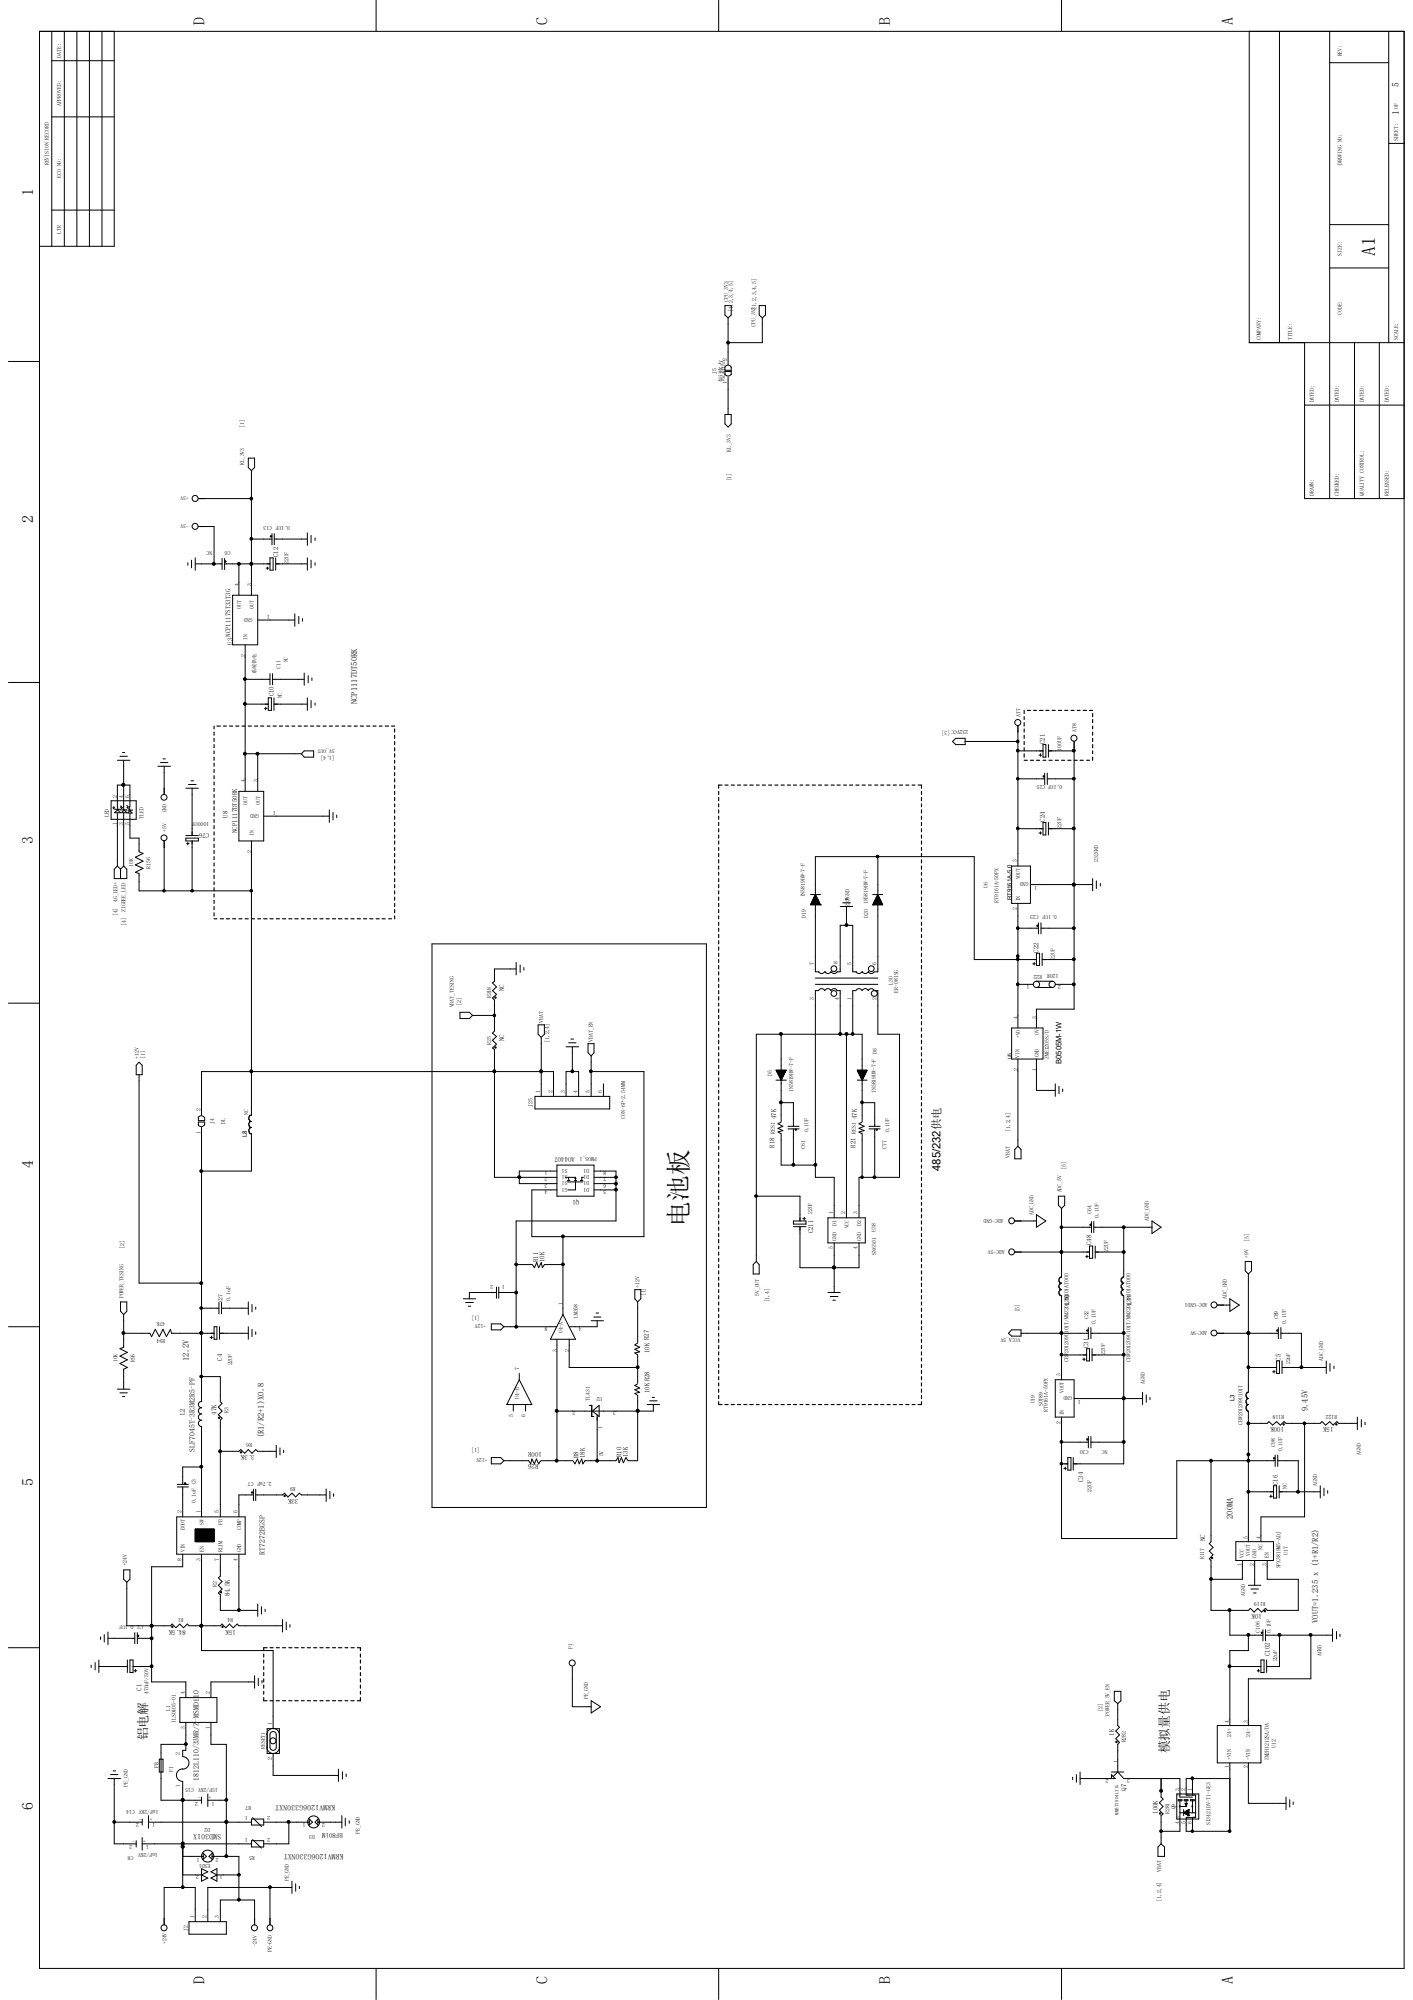
[picture p8: page 1]

LTR ECO NO: APPROVED:

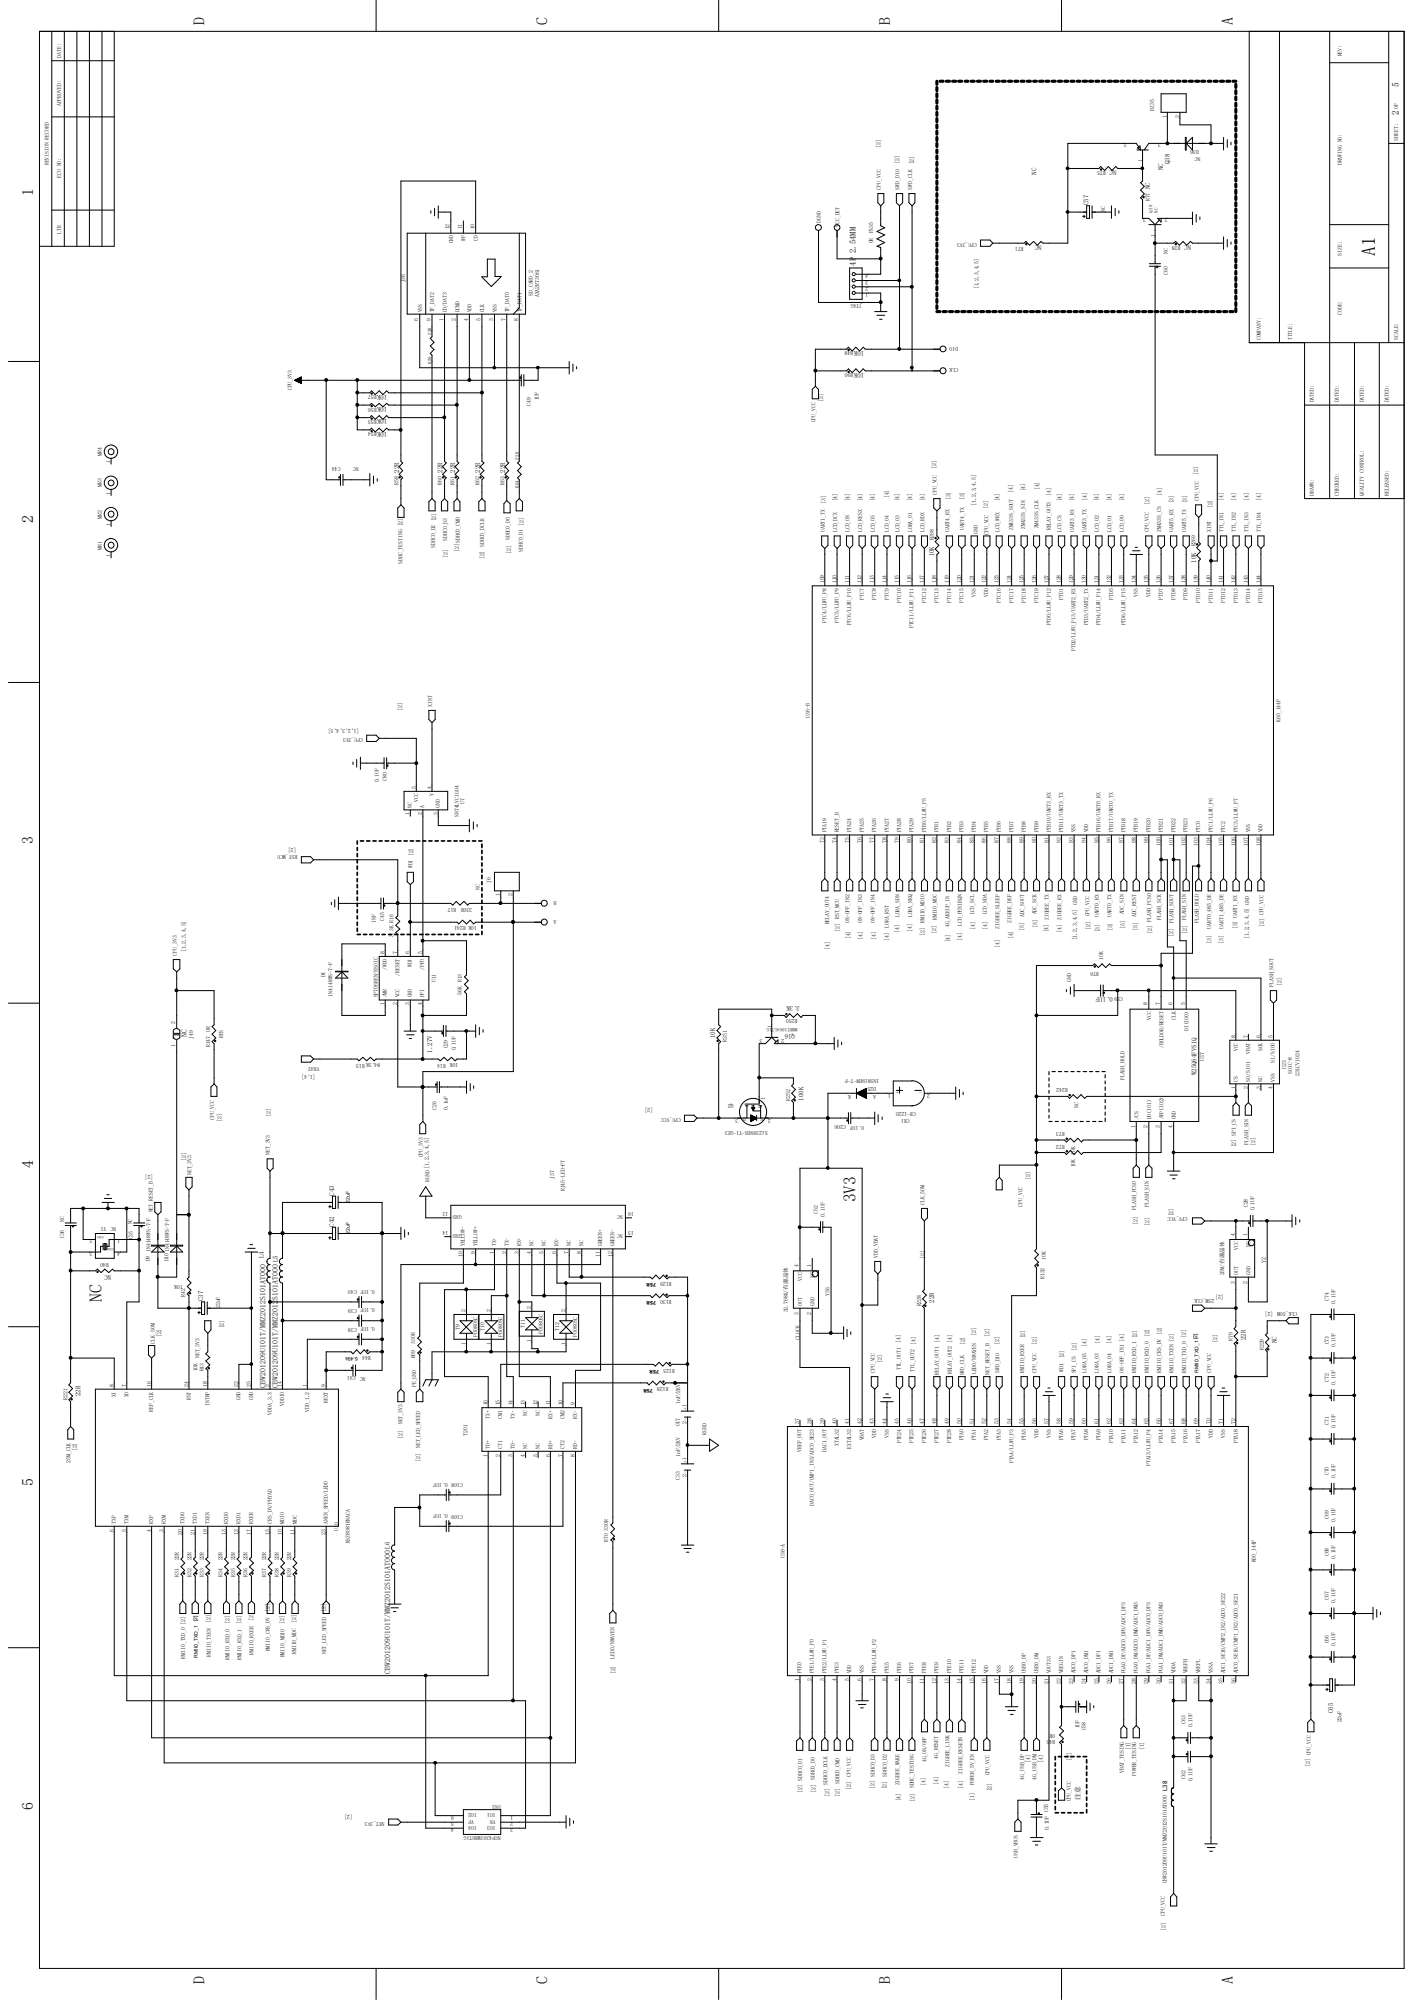
[picture p9: page 2]

LTR ECO NO: APPROVED:

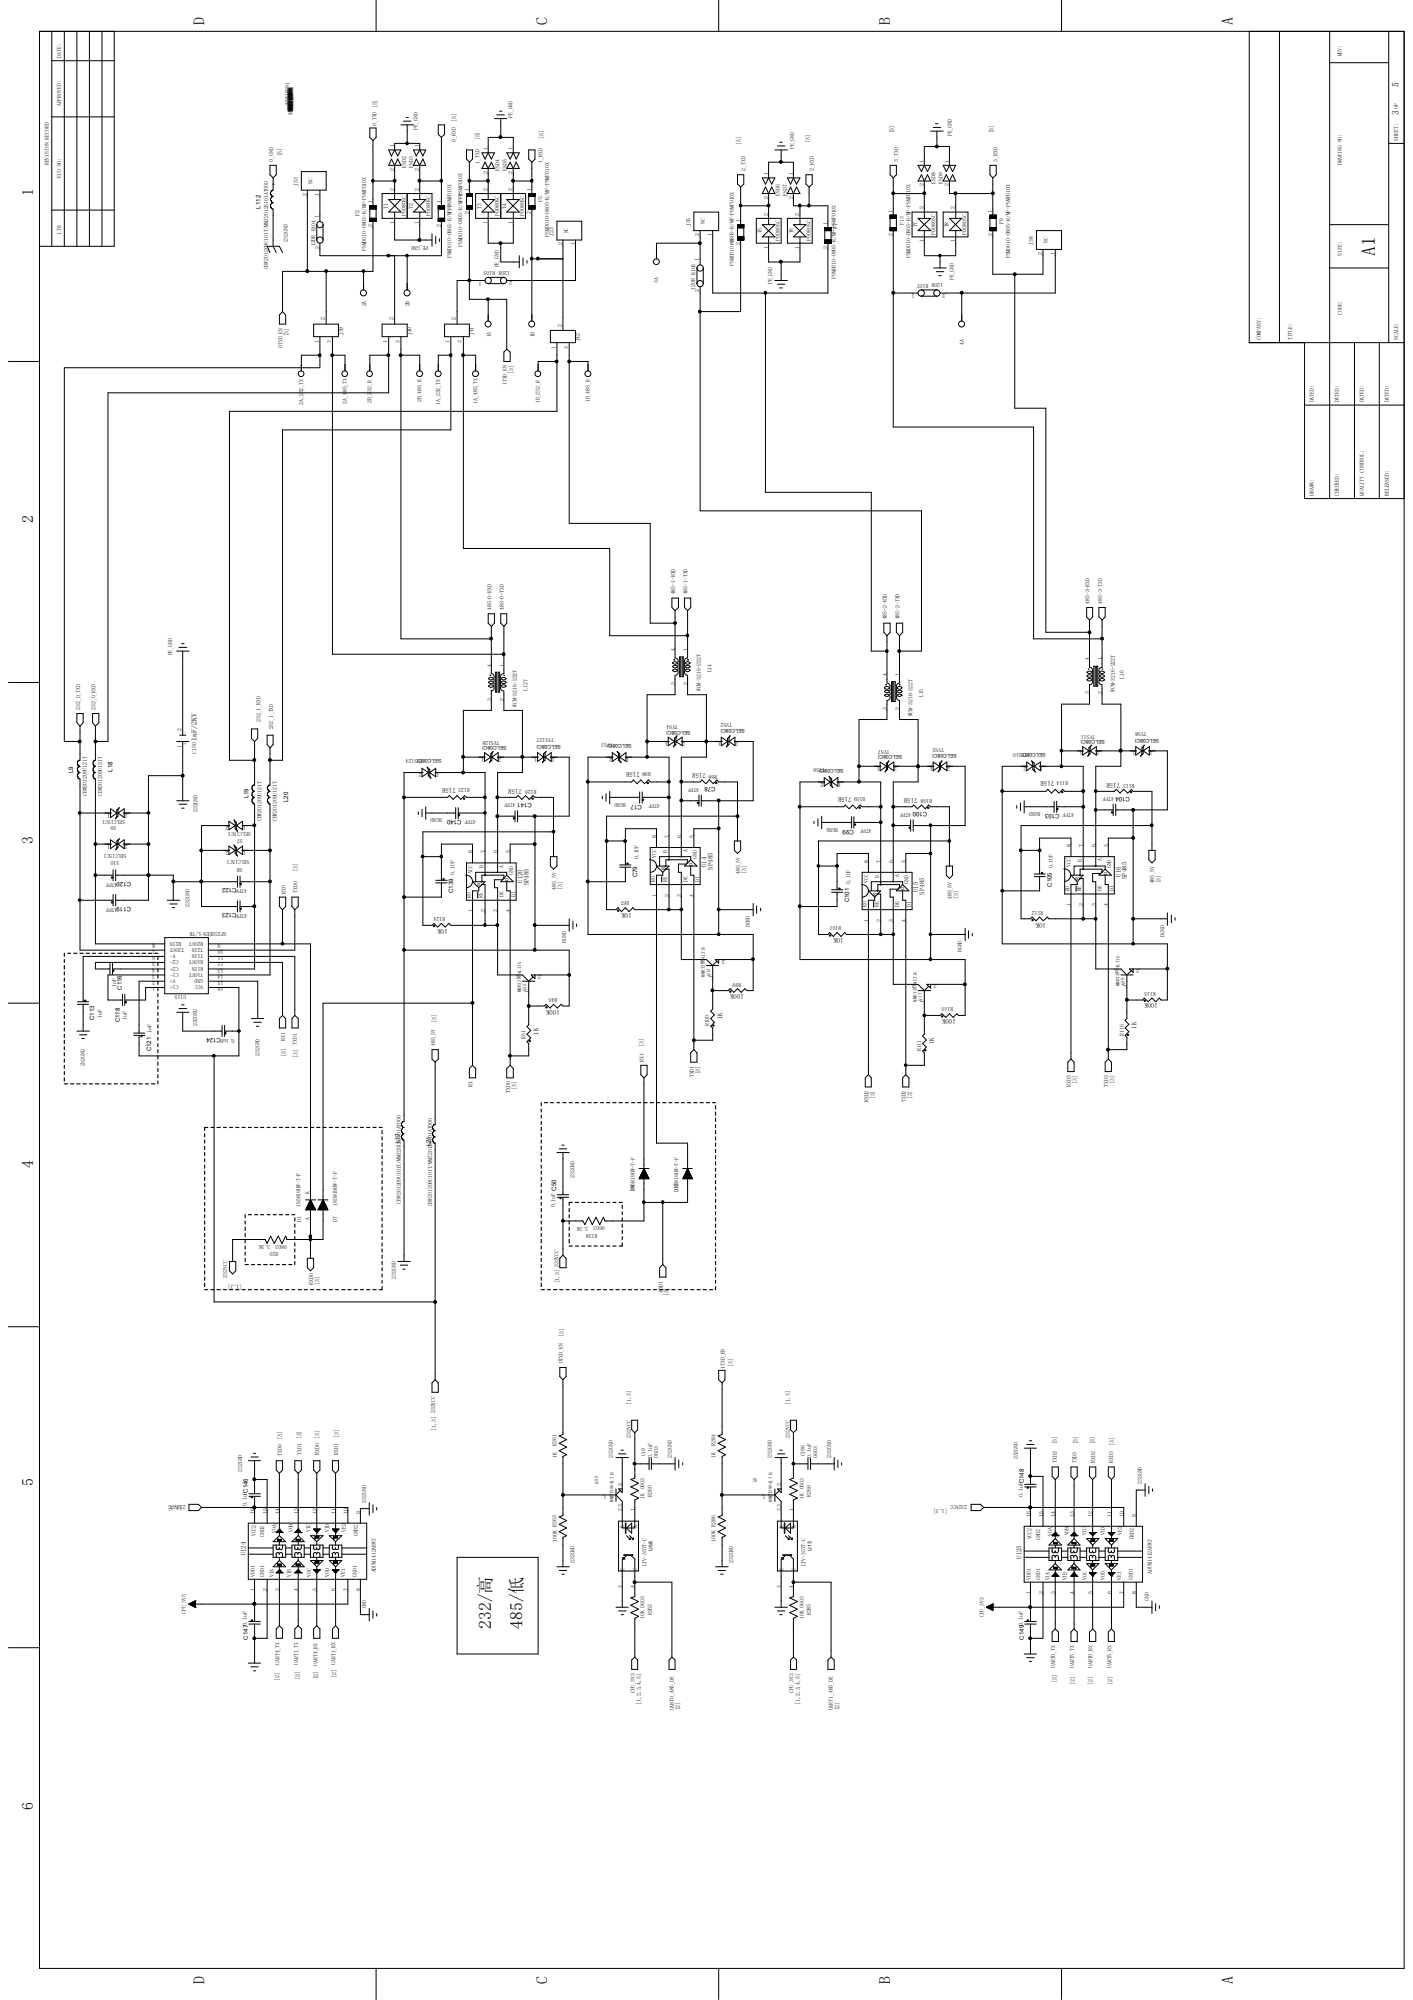
[picture p10: page 3]

LTR ECO NO: APPROVED:

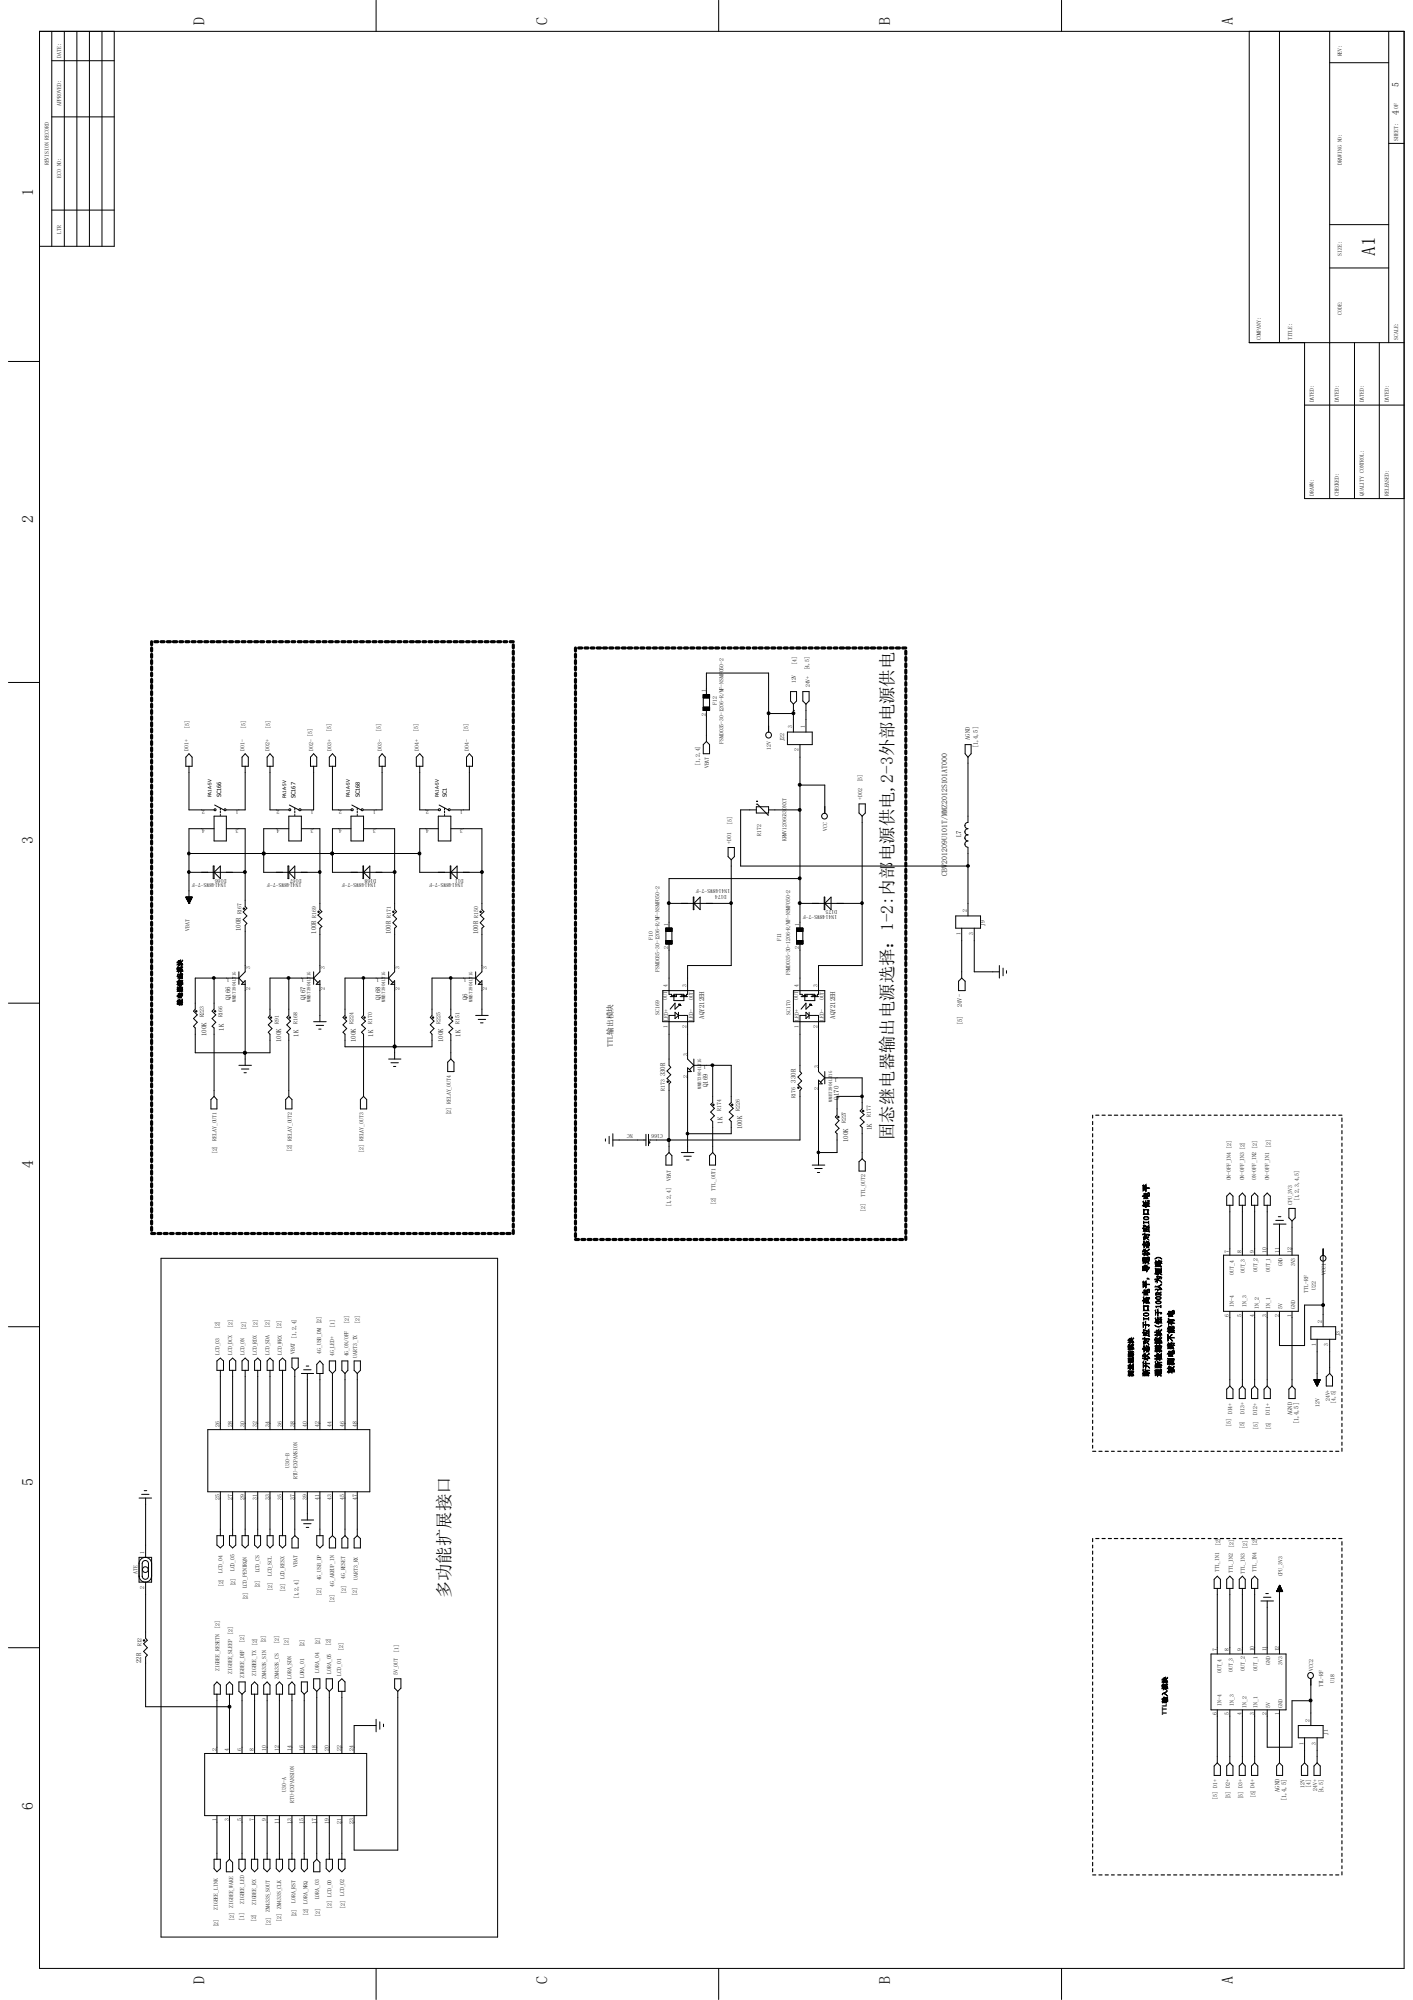
[picture p11: page 4]

LTR ECO NO: APPROVED:

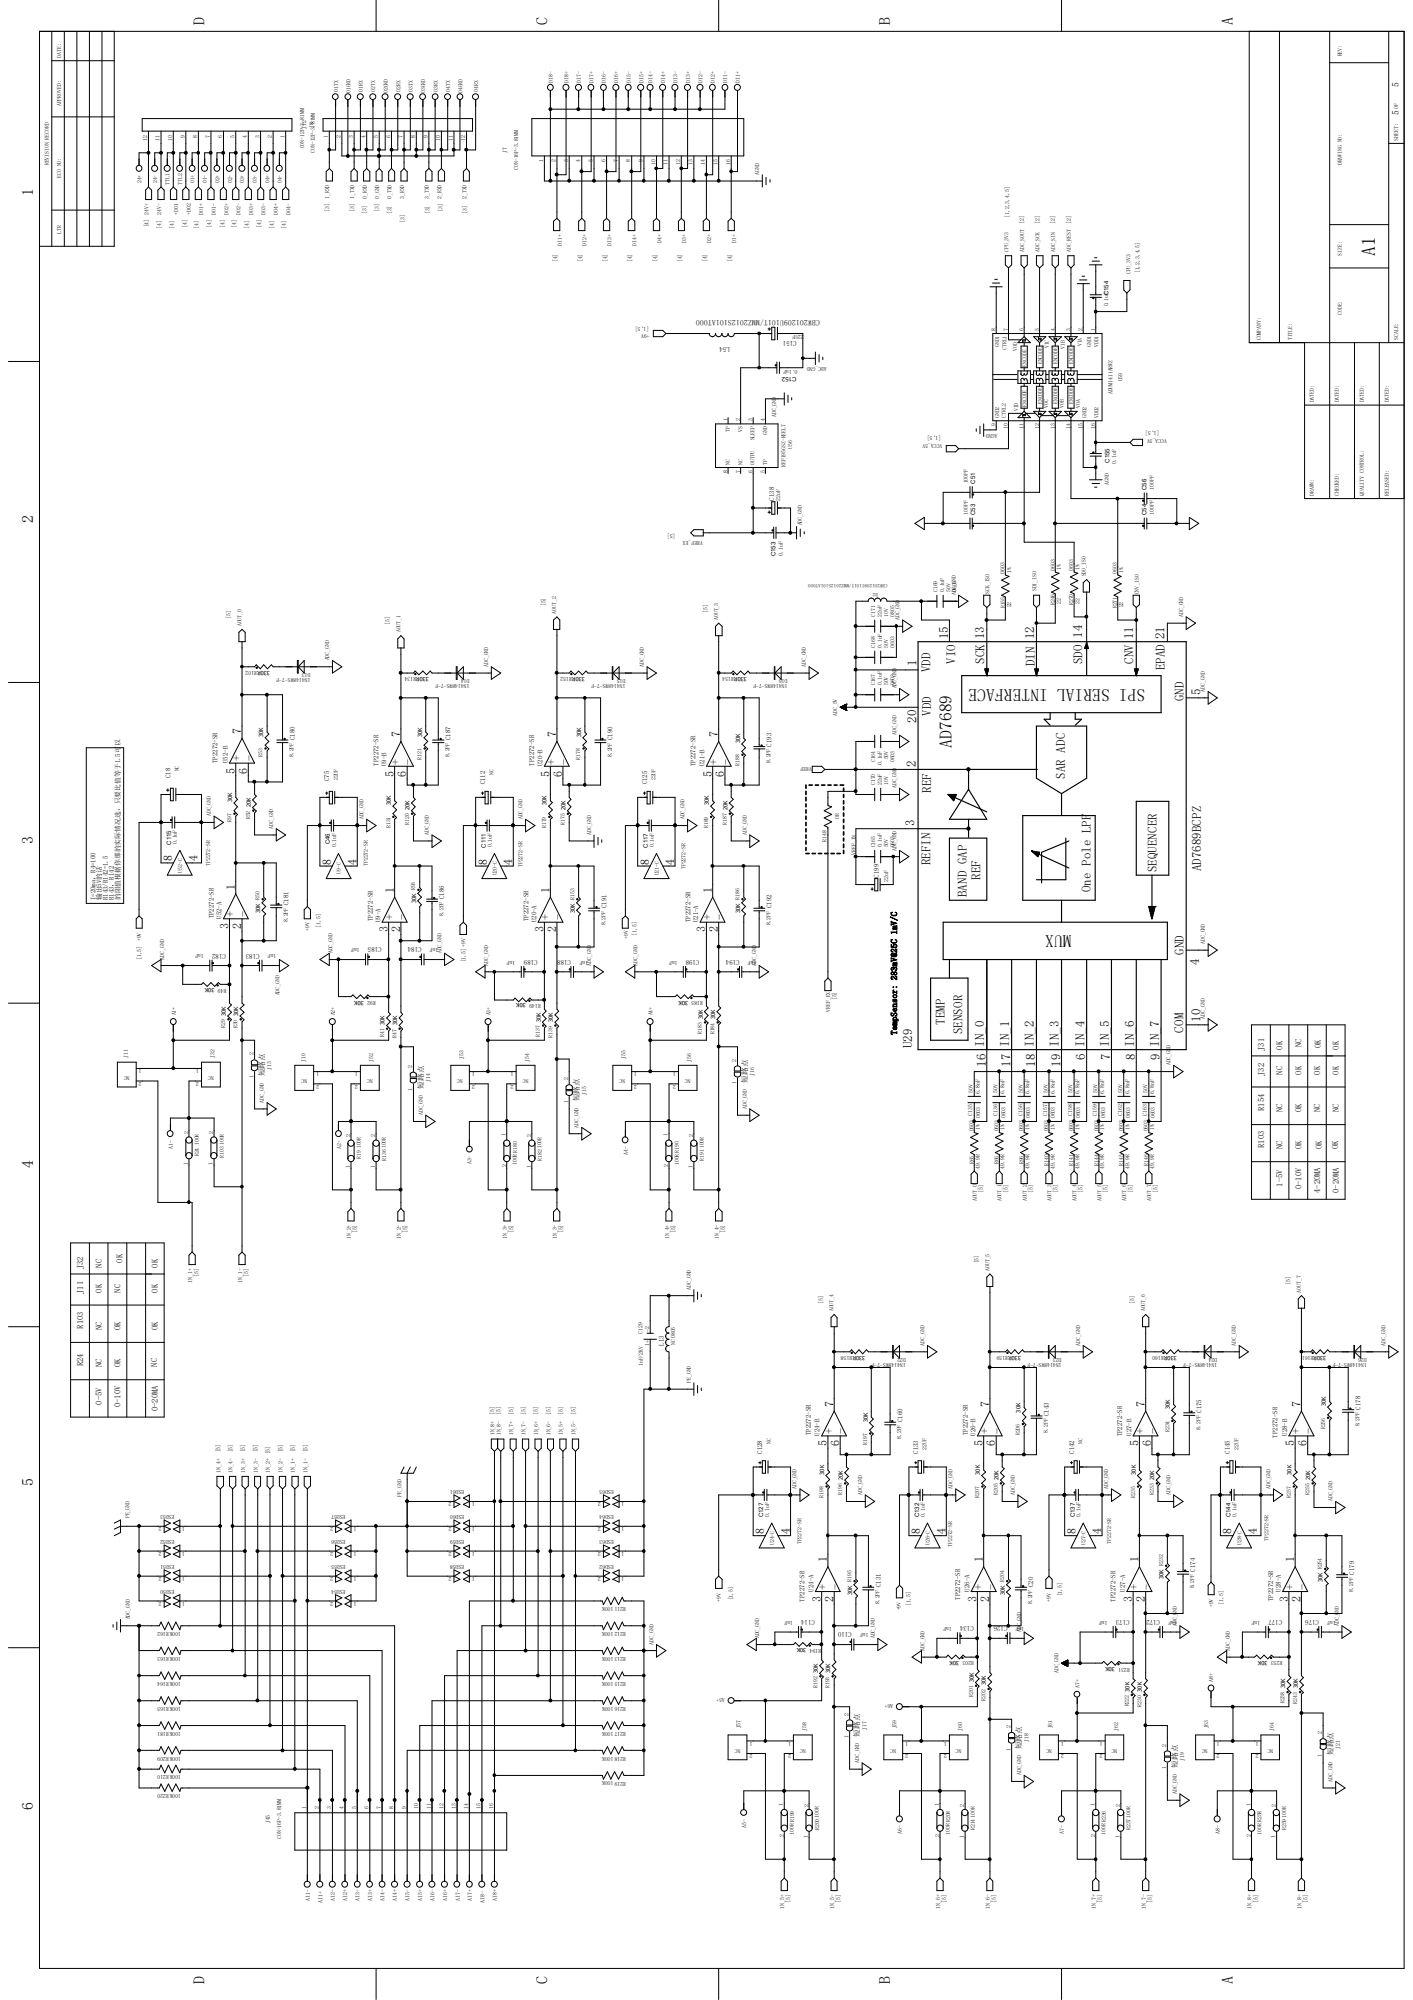
[picture p12: page 5]

LTR ECO NO: APPROVED:
