decomen/NXP-K64-gateway/hardware/ST-K60_Number.pdf

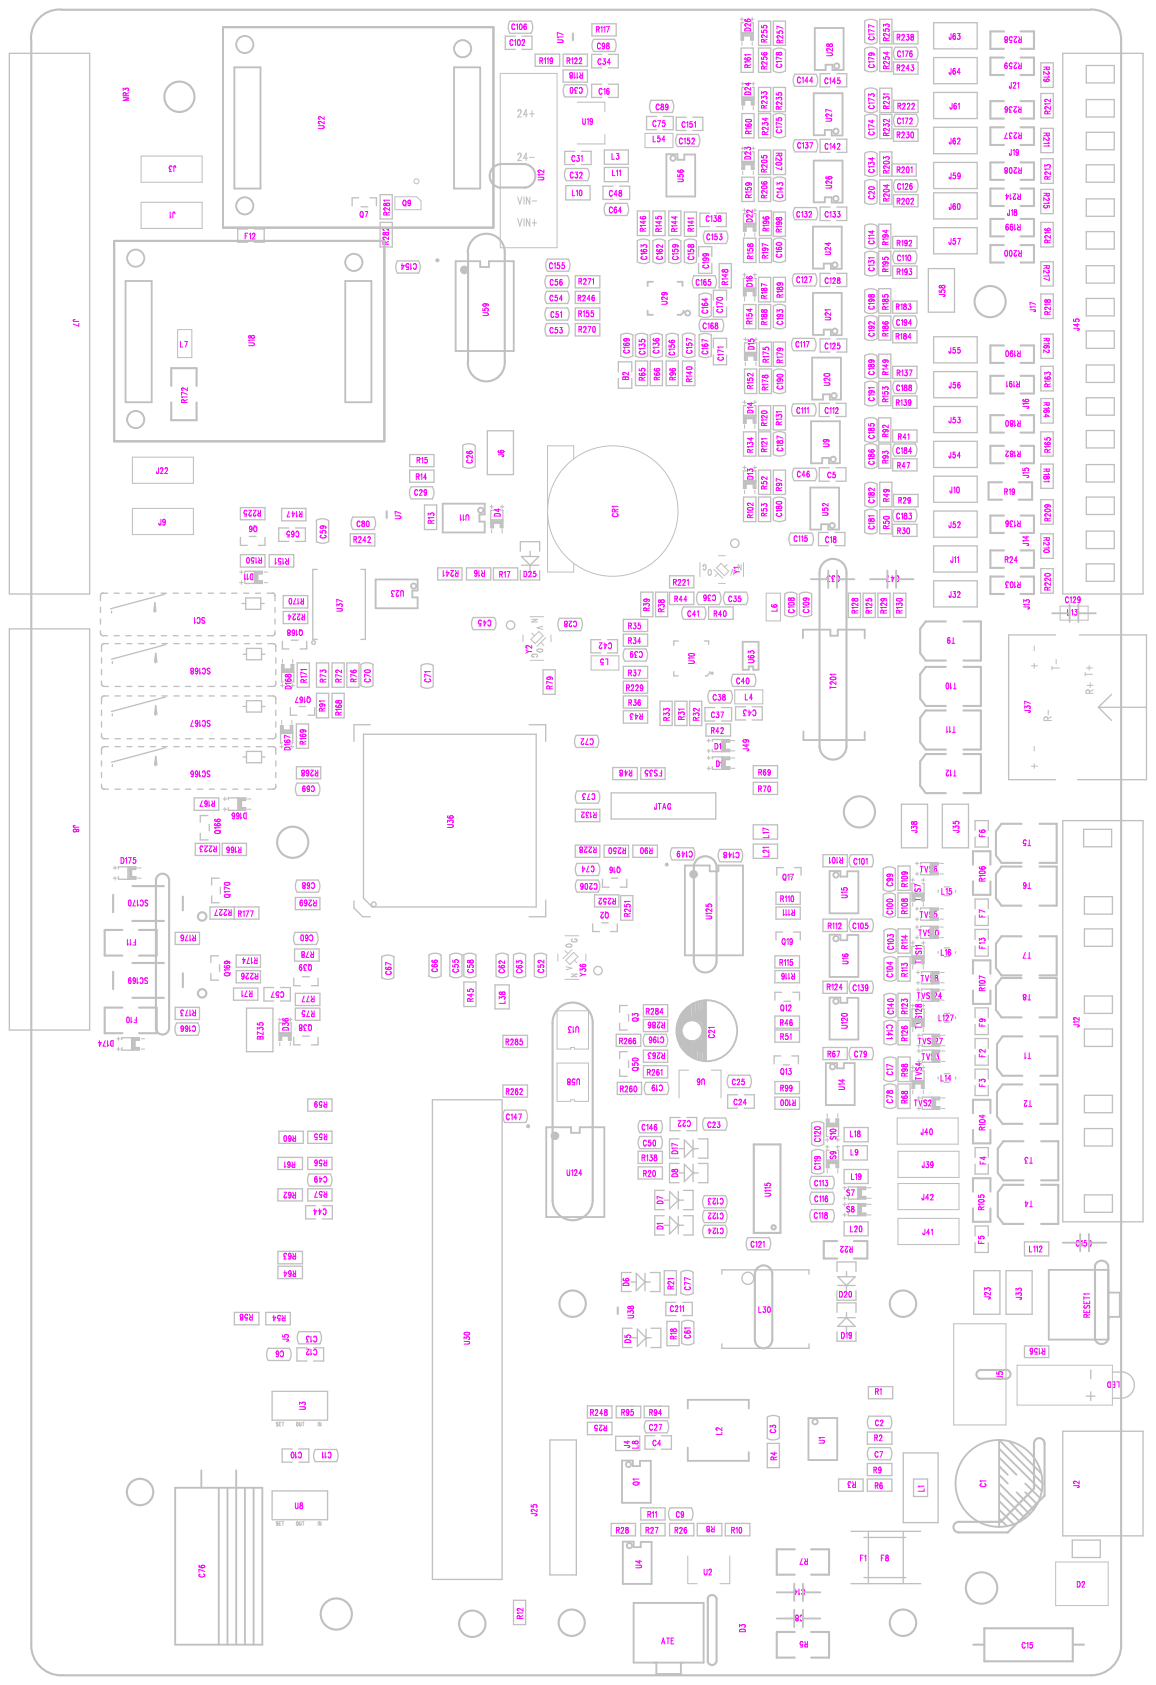
[picture p13: page 1]
