decomen/NXP-K64-gateway/software/RTU_Terminal/rt-thread/components/net/lwip-1.4.1/src/lwipopts.h

#define __LWIPOPTS_H__
#include <rtconfig.h>
#define ERRNO                       1
#define NO_SYS                      0
#define LWIP_SOCKET                 1
#define LWIP_NETCONN                1
#ifdef RT_LWIP_IGMP
#define LWIP_IGMP                   1
#else
#define LWIP_IGMP                   0
#endif
#ifdef RT_LWIP_ICMP
#define LWIP_ICMP                   1
#else
#define LWIP_ICMP                   0
#endif
#ifdef RT_LWIP_SNMP
#define LWIP_SNMP                   1
#else
#define LWIP_SNMP                   0
#endif
#ifdef RT_LWIP_DNS
#define LWIP_DNS                    1
#else
#define LWIP_DNS                    0
#endif
#define LWIP_HAVE_LOOPIF            0
#define LWIP_PLATFORM_BYTESWAP      0
#define BYTE_ORDER                  LITTLE_ENDIAN
#define LWIP_SO_RCVTIMEO            1
#define LWIP_SO_SNDTIMEO            1
#ifdef RT_LWIP_DEBUG
#define LWIP_DEBUG
#endif
#ifdef LWIP_DEBUG
#define SYS_DEBUG                   LWIP_DBG_OFF
#define ETHARP_DEBUG                LWIP_DBG_OFF
#define PPP_DEBUG                   LWIP_DBG_OFF
#define MEM_DEBUG                   LWIP_DBG_OFF
#define MEMP_DEBUG                  LWIP_DBG_OFF
#define PBUF_DEBUG                  LWIP_DBG_OFF
#define API_LIB_DEBUG               LWIP_DBG_OFF
#define API_MSG_DEBUG               LWIP_DBG_OFF
#define TCPIP_DEBUG                 LWIP_DBG_OFF
#define NETIF_DEBUG                 LWIP_DBG_OFF
#define SOCKETS_DEBUG               LWIP_DBG_OFF
#define DNS_DEBUG                   LWIP_DBG_OFF
#define AUTOIP_DEBUG                LWIP_DBG_OFF
#define DHCP_DEBUG                  LWIP_DBG_OFF
#define IP_DEBUG                    LWIP_DBG_OFF
#define IP_REASS_DEBUG              LWIP_DBG_OFF
#define ICMP_DEBUG                  LWIP_DBG_OFF
#define IGMP_DEBUG                  LWIP_DBG_OFF
#define UDP_DEBUG                   LWIP_DBG_OFF
#define TCP_DEBUG                   LWIP_DBG_OFF
#define TCP_INPUT_DEBUG             LWIP_DBG_OFF
#define TCP_OUTPUT_DEBUG            LWIP_DBG_OFF
#define TCP_RTO_DEBUG               LWIP_DBG_OFF
#define TCP_CWND_DEBUG              LWIP_DBG_OFF
#define TCP_WND_DEBUG               LWIP_DBG_OFF
#define TCP_FR_DEBUG                LWIP_DBG_OFF
#define TCP_QLEN_DEBUG              LWIP_DBG_OFF
#define TCP_RST_DEBUG               LWIP_DBG_OFF
#endif
#define LWIP_DBG_TYPES_ON           (LWIP_DBG_ON|LWIP_DBG_TRACE|LWIP_DBG_STATE|LWIP_DBG_FRESH|LWIP_DBG_HALT)
#define MEM_ALIGNMENT               4
#define MEM_LIBC_MALLOC             1
#define mem_malloc                  rt_malloc
#define mem_free                    rt_free
#define mem_calloc                  rt_calloc
#ifdef RT_LWIP_USING_RT_MEM
#define MEMP_MEM_MALLOC             1
#else
#define MEMP_MEM_MALLOC             0
#endif
#define MEMP_NUM_PBUF               48
#ifdef RT_LWIP_RAW_PCB_NUM
#define MEMP_NUM_RAW_PCB            RT_LWIP_RAW_PCB_NUM
#endif
#ifdef RT_LWIP_UDP_PCB_NUM
#define MEMP_NUM_UDP_PCB            RT_LWIP_UDP_PCB_NUM
#endif
#ifdef RT_LWIP_TCP_PCB_NUM
#define MEMP_NUM_TCP_PCB            RT_LWIP_TCP_PCB_NUM
#endif
#ifdef RT_LWIP_TCP_SEG_NUM
#define MEMP_NUM_TCP_SEG            RT_LWIP_TCP_SEG_NUM
#else
#define MEMP_NUM_TCP_SEG            TCP_SND_QUEUELEN
#endif
#define MEMP_NUM_NETBUF             12
#define MEMP_NUM_NETCONN            24
#define MEMP_NUM_TCPIP_MSG_API      16
#define MEMP_NUM_TCPIP_MSG_INPKT    16
#ifdef RT_LWIP_PBUF_NUM
#define PBUF_POOL_SIZE               RT_LWIP_PBUF_NUM
#endif
#ifdef RT_LWIP_PBUF_POOL_BUFSIZE
#define PBUF_POOL_BUFSIZE            RT_LWIP_PBUF_POOL_BUFSIZE
#endif
#define PBUF_LINK_HLEN              16
#ifdef RT_LWIP_ETH_PAD_SIZE
#define ETH_PAD_SIZE                RT_LWIP_ETH_PAD_SIZE
#endif
#define SYS_LIGHTWEIGHT_PROT        (NO_SYS==0)
#ifdef LWIP_USING_NAT
#define IP_NAT                      1
#else
#define IP_NAT                      0
#endif
#ifdef RT_LWIP_TCP
#define LWIP_TCP                    1
#else
#define LWIP_TCP                    0
#endif
#define TCP_TTL                     255
#define TCP_QUEUE_OOSEQ             1
#define TCP_MSS                     1460
#ifdef RT_LWIP_TCP_SND_BUF
#define TCP_SND_BUF                 RT_LWIP_TCP_SND_BUF
#else
#define TCP_SND_BUF                 (TCP_MSS * 2)
#endif
#define TCP_SND_QUEUELEN            (4 * TCP_SND_BUF/TCP_MSS)
#define TCP_SNDLOWAT                (TCP_SND_BUF/2)
#define TCP_SNDQUEUELOWAT           TCP_SND_QUEUELEN/2
#ifdef RT_LWIP_TCP_WND
#define TCP_WND                     RT_LWIP_TCP_WND
#else
#define TCP_WND                     (TCP_MSS * 2)
#endif
#define TCP_MAXRTX                  12
#define TCP_SYNMAXRTX               4
#ifdef RT_LWIP_TCPTHREAD_PRIORITY
#define TCPIP_MBOX_SIZE             RT_LWIP_TCPTHREAD_MBOX_SIZE
#define TCPIP_THREAD_PRIO           RT_LWIP_TCPTHREAD_PRIORITY
#define TCPIP_THREAD_STACKSIZE      RT_LWIP_TCPTHREAD_STACKSIZE
#else
#define TCPIP_MBOX_SIZE             8
#define TCPIP_THREAD_PRIO           128
#define TCPIP_THREAD_STACKSIZE      4096
#endif
#define TCPIP_THREAD_NAME           "tcpip"
#define DEFAULT_TCP_RECVMBOX_SIZE   10
#define LWIP_ARP                    1
#define ARP_TABLE_SIZE              10
#define ARP_QUEUEING                1
#define IP_FORWARD                  0
#ifdef RT_LWIP_REASSEMBLY_FRAG
#define IP_REASSEMBLY               1
#define IP_FRAG                     1
#define IP_REASS_MAX_PBUFS          10
#define MEMP_NUM_REASSDATA          10
#else
#define IP_REASSEMBLY               0
#define IP_FRAG                     0
#endif
#define ICMP_TTL                    255
#ifdef RT_LWIP_DHCP
#define LWIP_DHCP                   1
#else
#define LWIP_DHCP                   0
#endif
#define DHCP_DOES_ARP_CHECK         (LWIP_DHCP)
#define LWIP_AUTOIP                 0
#define LWIP_DHCP_AUTOIP_COOP       (LWIP_DHCP && LWIP_AUTOIP)
#ifdef RT_LWIP_UDP
#define LWIP_UDP                    1
#else
#define LWIP_UDP                    0
#endif
#define LWIP_UDPLITE                0
#define UDP_TTL                     255
#define DEFAULT_UDP_RECVMBOX_SIZE   1
#define DEFAULT_RAW_RECVMBOX_SIZE   1
#define DEFAULT_ACCEPTMBOX_SIZE     10
#ifdef RT_LWIP_STATS
#define LWIP_STATS                  1
#define LWIP_STATS_DISPLAY          1
#else
#define LWIP_STATS                  0
#endif
#if LWIP_STATS
#define LINK_STATS                  1
#define IP_STATS                    1
#define ICMP_STATS                  1
#define IGMP_STATS                  1
#define IPFRAG_STATS                1
#define UDP_STATS                   1
#define TCP_STATS                   1
#define MEM_STATS                   1
#define MEMP_STATS                  1
#define PBUF_STATS                  1
#define SYS_STATS                   1
#endif
#ifdef RT_LWIP_PPP
#define PPP_SUPPORT                 1
#else
#define PPP_SUPPORT                 0
#endif
#if PPP_SUPPORT
#define NUM_PPP                     1
#ifdef RT_LWIP_PPPOE
#define PPPOE_SUPPORT               1
#else
#define PPPOE_SUPPORT               0
#endif
#ifdef RT_LWIP_PPPOS
#define PPPOS_SUPPORT               1
#else
#define PPPOS_SUPPORT               0
#endif
#define PAP_SUPPORT                 1
#define CHAP_SUPPORT                1
#define MSCHAP_SUPPORT              0
#define CBCP_SUPPORT                0
#define CCP_SUPPORT                 0
#define VJ_SUPPORT                  1
#define MD5_SUPPORT                 1
#endif
#define LWIP_POSIX_SOCKETS_IO_NAMES 0
#define LWIP_NETIF_API  1
#define MEMP_NUM_SYS_TIMEOUT       (LWIP_TCP + IP_REASSEMBLY + LWIP_ARP + (2*LWIP_DHCP) + LWIP_AUTOIP + LWIP_IGMP + LWIP_DNS + PPP_SUPPORT)
#ifdef LWIP_IGMP
#include <stdlib.h>
#define LWIP_RAND                  rand
#endif
