decomen/NXP-K64-gateway/software/RTU_Terminal/rt-thread/components/net/freemodbus/modbus/ascii/mbascii.c

/* 
 * FreeModbus Libary: A portable Modbus implementation for Modbus ASCII/RTU.
 * Copyright (c) 2006 Christian Walter <wolti@sil.at>
 * All rights reserved.
 *
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
 * File: $Id: mbascii.c,v 1.15 2007/02/18 23:46:48 wolti Exp $
 */

/* ----------------------- System includes ----------------------------------*/
#include "stdlib.h"
#include "string.h"

/* ----------------------- Platform includes --------------------------------*/
#include "port.h"

/* ----------------------- Modbus includes ----------------------------------*/
#include "mb.h"
#include "mbconfig.h"
#include "mbascii.h"
#include "mbframe.h"

#include "mbcrc.h"
#include "mbport.h"

#if MB_SLAVE_ASCII_ENABLED > 0

/* ----------------------- Defines ------------------------------------------*/
#define MB_ASCII_DEFAULT_CR     '\r'    /*!< Default CR character for Modbus ASCII. */
#define MB_ASCII_DEFAULT_LF     '\n'    /*!< Default LF character for Modbus ASCII. */
#define MB_SER_PDU_SIZE_MIN     3       /*!< Minimum size of a Modbus ASCII frame. */
#define MB_SER_PDU_SIZE_MAX     256     /*!< Maximum size of a Modbus ASCII frame. */
#define MB_SER_PDU_SIZE_LRC     1       /*!< Size of LRC field in PDU. */
#define MB_SER_PDU_ADDR_OFF     0       /*!< Offset of slave address in Ser-PDU. */
#define MB_SER_PDU_PDU_OFF      1       /*!< Offset of Modbus-PDU in Ser-PDU. */

/* ----------------------- Type definitions ---------------------------------*/
typedef enum
{
    STATE_RX_IDLE,              /*!< Receiver is in idle state. */
    STATE_RX_RCV,               /*!< Frame is beeing received. */
    STATE_RX_WAIT_EOF           /*!< Wait for End of Frame. */
} eMBRcvState;

typedef enum
{
    STATE_TX_IDLE,              /*!< Transmitter is in idle state. */
    STATE_TX_START,             /*!< Starting transmission (':' sent). */
    STATE_TX_DATA,              /*!< Sending of data (Address, Data, LRC). */
    STATE_TX_END,               /*!< End of transmission. */
    STATE_TX_NOTIFY             /*!< Notify sender that the frame has been sent. */
} eMBSndState;

typedef enum
{
    BYTE_HIGH_NIBBLE,           /*!< Character for high nibble of byte. */
    BYTE_LOW_NIBBLE             /*!< Character for low nibble of byte. */
} eMBBytePos;

/* ----------------------- Static functions ---------------------------------*/
static UCHAR    prvucMBCHAR2BIN( UCHAR ucCharacter );

static UCHAR    prvucMBBIN2CHAR( UCHAR ucByte );

static UCHAR    prvucMBLRC( UCHAR * pucFrame, USHORT usLen );

/* ----------------------- Static variables ---------------------------------*/
static volatile eMBSndState eSndState[BOARD_UART_MAX];
static volatile eMBRcvState eRcvState[BOARD_UART_MAX];

static volatile UCHAR *ucASCIIBuf[BOARD_UART_MAX];

static volatile USHORT usRcvBufferPos[BOARD_UART_MAX];
static volatile eMBBytePos eBytePos[BOARD_UART_MAX];

static volatile UCHAR *pucSndBufferCur[BOARD_UART_MAX];
static volatile USHORT usSndBufferCount[BOARD_UART_MAX];

static volatile UCHAR ucLRC[BOARD_UART_MAX];
static volatile UCHAR ucMBLFCharacter[BOARD_UART_MAX];

/* ----------------------- Start implementation -----------------------------*/
eMBErrorCode
eMBASCIIInit( UCHAR ucSlaveAddress, UCHAR ucPort, ULONG ulBaudRate, eMBParity eParity )
{
    eMBErrorCode    eStatus = MB_ENOERR;
    ( void )ucSlaveAddress;
    
    RT_KERNEL_FREE( (void *)ucASCIIBuf[ucPort] );
    ucASCIIBuf[ucPort] = RT_KERNEL_CALLOC( MB_SER_PDU_SIZE_MAX );
    
    ENTER_CRITICAL_SECTION(  );
    ucMBLFCharacter[ucPort] = MB_ASCII_DEFAULT_LF;

    if( xMBPortSerialInit( ucPort, ulBaudRate, 7, eParity ) != TRUE )
    {
        eStatus = MB_EPORTERR;
    }
    else if( xMBPortTimersInit( ucPort, MB_ASCII_TIMEOUT_SEC * 20000UL ) != TRUE )
    {
        eStatus = MB_EPORTERR;
    }

    EXIT_CRITICAL_SECTION(  );

    return eStatus;
}

void
eMBASCIIStart( UCHAR ucPort )
{
    ENTER_CRITICAL_SECTION(  );
    vMBPortSerialEnable( ucPort, TRUE, FALSE );
    eRcvState[ucPort] = STATE_RX_IDLE;
    EXIT_CRITICAL_SECTION(  );

    /* No special startup required for ASCII. */
    ( void )xMBPortEventPost( ucPort, EV_READY );
}

void
eMBASCIIStop( UCHAR ucPort )
{
    ENTER_CRITICAL_SECTION(  );
    vMBPortSerialEnable( ucPort, FALSE, FALSE );
    vMBPortTimersDisable( ucPort );
    EXIT_CRITICAL_SECTION(  );
}

eMBErrorCode
eMBASCIIReceive( UCHAR ucPort, UCHAR * pucRcvAddress, UCHAR ** pucFrame, USHORT * pusLength )
{
    eMBErrorCode    eStatus = MB_ENOERR;

    ENTER_CRITICAL_SECTION(  );
    assert( usRcvBufferPos[ucPort] < MB_SER_PDU_SIZE_MAX );

    /* Length and CRC check */
    if( ( usRcvBufferPos[ucPort] >= MB_SER_PDU_SIZE_MIN )
        && ( prvucMBLRC( ( UCHAR * ) ucASCIIBuf[ucPort], usRcvBufferPos[ucPort] ) == 0 ) )
    {
        /* Save the address field. All frames are passed to the upper layed
         * and the decision if a frame is used is done there.
         */
        *pucRcvAddress = ucASCIIBuf[ucPort][MB_SER_PDU_ADDR_OFF];

        /* Total length of Modbus-PDU is Modbus-Serial-Line-PDU minus
         * size of address field and CRC checksum.
         */
        *pusLength = ( USHORT )( usRcvBufferPos[ucPort] - MB_SER_PDU_PDU_OFF - MB_SER_PDU_SIZE_LRC );

        /* Return the start of the Modbus PDU to the caller. */
        *pucFrame = ( UCHAR * ) & ucASCIIBuf[ucPort][MB_SER_PDU_PDU_OFF];
    }
    else
    {
        eStatus = MB_EIO;
    }
    EXIT_CRITICAL_SECTION(  );
    return eStatus;
}

eMBErrorCode
eMBASCIISend( UCHAR ucPort, UCHAR ucSlaveAddress, const UCHAR * pucFrame, USHORT usLength )
{
    eMBErrorCode    eStatus = MB_ENOERR;
    UCHAR           usLRC;

    ENTER_CRITICAL_SECTION(  );

    // add by jay 2016/11/24
    if (eRcvState[ucPort] != STATE_RX_IDLE && !xMBIsPortTimersEnable(ucPort)) {
        // 定时器未开启, 初始化接收状态, 防止无法发送
        eRcvState[ucPort] = STATE_RX_IDLE;
    }
    
    /* Check if the receiver is still in idle state. If not we where to
     * slow with processing the received frame and the master sent another
     * frame on the network. We have to abort sending the frame.
     */
    if( eRcvState[ucPort] == STATE_RX_IDLE )
    {
        /* First byte before the Modbus-PDU is the slave address. */
        pucSndBufferCur[ucPort] = ( UCHAR * ) pucFrame - 1;
        usSndBufferCount[ucPort] = 1;

        /* Now copy the Modbus-PDU into the Modbus-Serial-Line-PDU. */
        pucSndBufferCur[ucPort][MB_SER_PDU_ADDR_OFF] = ucSlaveAddress;
        usSndBufferCount[ucPort] += usLength;

        /* Calculate LRC checksum for Modbus-Serial-Line-PDU. */
        usLRC = prvucMBLRC( ( UCHAR * ) pucSndBufferCur[ucPort], usSndBufferCount[ucPort] );
        ucASCIIBuf[ucPort][usSndBufferCount[ucPort]++] = usLRC;

        /* Activate the transmitter. */
        eSndState[ucPort] = STATE_TX_START;
        vMBPortSerialEnable( ucPort, FALSE, TRUE );
    }
    else
    {
        eStatus = MB_EIO;
    }
    EXIT_CRITICAL_SECTION(  );
    return eStatus;
}

BOOL
xMBASCIIReceiveFSM( UCHAR ucPort )
{
    BOOL            xNeedPoll = FALSE;
    UCHAR           ucByte;
    UCHAR           ucResult;

    assert( eSndState[ucPort] == STATE_TX_IDLE );

    ( void )xMBPortSerialGetByte( ucPort, ( CHAR * ) & ucByte );
    switch ( eRcvState[ucPort] )
    {
        /* A new character is received. If the character is a ':' the input
         * buffer is cleared. A CR-character signals the end of the data
         * block. Other characters are part of the data block and their
         * ASCII value is converted back to a binary representation.
         */
    case STATE_RX_RCV:
        /* Enable timer for character timeout. */
        vMBPortTimersEnable( ucPort );
        if( ucByte == ':' )
        {
            /* Empty receive buffer. */
            eBytePos[ucPort] = BYTE_HIGH_NIBBLE;
            usRcvBufferPos[ucPort] = 0;
        }
        else if( ucByte == MB_ASCII_DEFAULT_CR )
        {
            eRcvState[ucPort] = STATE_RX_WAIT_EOF;
        }
        else
        {
            ucResult = prvucMBCHAR2BIN( ucByte );
            switch ( eBytePos[ucPort] )
            {
                /* High nibble of the byte comes first. We check for
                 * a buffer overflow here. */
            case BYTE_HIGH_NIBBLE:
                if( usRcvBufferPos[ucPort] < MB_SER_PDU_SIZE_MAX )
                {
                    ucASCIIBuf[ucPort][usRcvBufferPos[ucPort]] = ( UCHAR )( ucResult << 4 );
                    eBytePos[ucPort] = BYTE_LOW_NIBBLE;
                    break;
                }
                else
                {
                    /* not handled in Modbus specification but seems
                     * a resonable implementation. */
                    eRcvState[ucPort] = STATE_RX_IDLE;
                    /* Disable previously activated timer because of error state. */
                    vMBPortTimersDisable( ucPort );
                }
                break;

            case BYTE_LOW_NIBBLE:
                ucASCIIBuf[ucPort][usRcvBufferPos[ucPort]++] |= ucResult;
                eBytePos[ucPort] = BYTE_HIGH_NIBBLE;
                break;
            }
        }
        break;

    case STATE_RX_WAIT_EOF:
        if( ucByte == ucMBLFCharacter[ucPort] )
        {
            /* Disable character timeout timer because all characters are
             * received. */
            vMBPortTimersDisable( ucPort );
            /* Receiver is again in idle state. */
            eRcvState[ucPort]= STATE_RX_IDLE;

            /* Notify the caller of eMBASCIIReceive that a new frame
             * was received. */
            xNeedPoll = xMBPortEventPost( ucPort, EV_FRAME_RECEIVED );
        }
        else if( ucByte == ':' )
        {
            /* Empty receive buffer and back to receive state. */
            eBytePos[ucPort] = BYTE_HIGH_NIBBLE;
            usRcvBufferPos[ucPort] = 0;
            eRcvState[ucPort] = STATE_RX_RCV;

            /* Enable timer for character timeout. */
            vMBPortTimersEnable( ucPort );
        }
        else
        {
            /* Frame is not okay. Delete entire frame. */
            eRcvState[ucPort] = STATE_RX_IDLE;
        }
        break;

    case STATE_RX_IDLE:
        if( ucByte == ':' )
        {
            /* Enable timer for character timeout. */
            vMBPortTimersEnable( ucPort );
            /* Reset the input buffers to store the frame. */
            usRcvBufferPos[ucPort] = 0;;
            eBytePos[ucPort] = BYTE_HIGH_NIBBLE;
            eRcvState[ucPort] = STATE_RX_RCV;
        }
        break;
    }

    return xNeedPoll;
}

BOOL
xMBASCIITransmitFSM( UCHAR ucPort )
{
    BOOL            xNeedPoll = FALSE;
    UCHAR           ucByte;

    assert( eRcvState[ucPort] == STATE_RX_IDLE );
    switch ( eSndState[ucPort] )
    {
        /* Start of transmission. The start of a frame is defined by sending
         * the character ':'. */
    case STATE_TX_START:
        ucByte = ':';
        xMBPortSerialPutByte( ucPort, ( CHAR )ucByte );
        eSndState[ucPort] = STATE_TX_DATA;
        eBytePos[ucPort] = BYTE_HIGH_NIBBLE;
        break;

        /* Send the data block. Each data byte is encoded as a character hex
         * stream with the high nibble sent first and the low nibble sent
         * last. If all data bytes are exhausted we send a '\r' character
         * to end the transmission. */
    case STATE_TX_DATA:
        if( usSndBufferCount[ucPort] > 0 )
        {
            switch ( eBytePos[ucPort] )
            {
            case BYTE_HIGH_NIBBLE:
                ucByte = prvucMBBIN2CHAR( ( UCHAR )( *pucSndBufferCur[ucPort] >> 4 ) );
                xMBPortSerialPutByte( ucPort, ( CHAR ) ucByte );
                eBytePos[ucPort] = BYTE_LOW_NIBBLE;
                break;

            case BYTE_LOW_NIBBLE:
                ucByte = prvucMBBIN2CHAR( ( UCHAR )( *pucSndBufferCur[ucPort] & 0x0F ) );
                xMBPortSerialPutByte( ucPort, ( CHAR )ucByte );
                pucSndBufferCur[ucPort]++;
                eBytePos[ucPort] = BYTE_HIGH_NIBBLE;
                usSndBufferCount[ucPort]--;
                break;
            }
        }
        else
        {
            xMBPortSerialPutByte( ucPort, MB_ASCII_DEFAULT_CR );
            eSndState[ucPort] = STATE_TX_END;
        }
        break;

        /* Finish the frame by sending a LF character. */
    case STATE_TX_END:
        xMBPortSerialPutByte( ucPort, ( CHAR )ucMBLFCharacter[ucPort] );
        /* We need another state to make sure that the CR character has
         * been sent. */
        eSndState[ucPort] = STATE_TX_NOTIFY;
        break;

        /* Notify the task which called eMBASCIISend that the frame has
         * been sent. */
    case STATE_TX_NOTIFY:
        eSndState[ucPort] = STATE_TX_IDLE;
        xNeedPoll = xMBPortEventPost( ucPort, EV_FRAME_SENT );

        /* Disable transmitter. This prevents another transmit buffer
         * empty interrupt. */
        vMBPortSerialEnable( ucPort, TRUE, FALSE );
        eSndState[ucPort] = STATE_TX_IDLE;
        break;

        /* We should not get a transmitter event if the transmitter is in
         * idle state.  */
    case STATE_TX_IDLE:
        /* enable receiver/disable transmitter. */
        vMBPortSerialEnable( ucPort, TRUE, FALSE );
        break;
    }

    return xNeedPoll;
}

BOOL
xMBASCIITimerT1SExpired( UCHAR ucPort )
{
    switch ( eRcvState[ucPort] )
    {
        /* If we have a timeout we go back to the idle state and wait for
         * the next frame.
         */
    case STATE_RX_RCV:
    case STATE_RX_WAIT_EOF:
        eRcvState[ucPort] = STATE_RX_IDLE;
        break;

    default:
        assert( ( eRcvState[ucPort] == STATE_RX_RCV ) || ( eRcvState[ucPort] == STATE_RX_WAIT_EOF ) );
        break;
    }
    vMBPortTimersDisable( ucPort );

    /* no context switch required. */
    return FALSE;
}


static          UCHAR
prvucMBCHAR2BIN( UCHAR ucCharacter )
{
    if( ( ucCharacter >= '0' ) && ( ucCharacter <= '9' ) )
    {
        return ( UCHAR )( ucCharacter - '0' );
    }
    else if( ( ucCharacter >= 'A' ) && ( ucCharacter <= 'F' ) )
    {
        return ( UCHAR )( ucCharacter - 'A' + 0x0A );
    }
    else
    {
        return 0xFF;
    }
}

static          UCHAR
prvucMBBIN2CHAR( UCHAR ucByte )
{
    if( ucByte <= 0x09 )
    {
        return ( UCHAR )( '0' + ucByte );
    }
    else if( ( ucByte >= 0x0A ) && ( ucByte <= 0x0F ) )
    {
        return ( UCHAR )( ucByte - 0x0A + 'A' );
    }
    else
    {
        /* Programming error. */
        assert( 0 );
    }
    return '0';
}


static          UCHAR
prvucMBLRC( UCHAR * pucFrame, USHORT usLen )
{
    UCHAR           ucLRC = 0;  /* LRC char initialized */

    while( usLen-- )
    {
        ucLRC += *pucFrame++;   /* Add buffer byte without carry */
    }

    /* Return twos complement */
    ucLRC = ( UCHAR ) ( -( ( CHAR ) ucLRC ) );
    return ucLRC;
}

#endif
