decomen/NXP-K64-gateway/software/RTU_Terminal/board/cfg/tcpip_cfg.c

#include <board.h>
#include <stdio.h>

tcpip_cfg_t g_tcpip_cfgs[BOARD_TCPIP_MAX];
tcpip_state_t g_tcpip_states[BOARD_TCPIP_MAX];
const tcpip_cfg_t c_tcpip_cfg_default = {
    .enable = RT_FALSE,
    .tcpip_type = TCP_IP_TCP,
    .tcpip_cs = TCPIP_CLIENT,
    .peer = "",
    .port = 0,
    .interval = 0,
    .keepalive = RT_TRUE,
    .mode = TCP_IP_M_NORMAL,
    .cfg.normal = {
        .proto_type = PROTO_MODBUS_TCP,
        .proto_ms = PROTO_SLAVE,
        .maddress = 1,
    }
};

static void prvSetTcpipCfgsDefault(void)
{
    memset(&g_tcpip_cfgs[0], 0, sizeof(g_tcpip_cfgs));
    for (int i = 0; i < BOARD_TCPIP_MAX; i++) {
        g_tcpip_cfgs[i] = c_tcpip_cfg_default;
    }
}

static void prvReadTcpipCfgsFromFs(void)
{
    if (!board_cfg_read(TCPIP_CFG_OFS, &g_tcpip_cfgs[0], sizeof(g_tcpip_cfgs))) {
        prvSetTcpipCfgsDefault();
    }
}

void prvSaveTcpipCfgsToFs(void)
{
    if (!board_cfg_write(TCPIP_CFG_OFS, &g_tcpip_cfgs[0], sizeof(g_tcpip_cfgs))) {
        ; //prvSetTcpipCfgsDefault();
    }
}

rt_err_t tcpip_cfg_init(void)
{
    prvReadTcpipCfgsFromFs();
    for (int i = 0; i < BOARD_TCPIP_MAX; i++) {
        g_tcpip_states[i].enable = g_tcpip_cfgs[i].enable;
        g_tcpip_states[i].ulConnTime = 0;
        g_tcpip_states[i].eState = TCPIP_STATE_WAIT;
    }
    return RT_EOK;
}

// for webserver
void setTcpipCfgWithJson(cJSON *pCfg)
{
    int n = cJSON_GetInt(pCfg, "n", -1);
    int en = cJSON_GetInt(pCfg, "en", -1);
    int tt = cJSON_GetInt(pCfg, "tt", -1);
    int cs = cJSON_GetInt(pCfg, "cs", -1);
    const char *pe = cJSON_GetString(pCfg, "pe", VAR_NULL);
    int po = cJSON_GetInt(pCfg, "po", -1);
    int it = cJSON_GetInt(pCfg, "it", -1);
    int kl = cJSON_GetInt(pCfg, "kl", -1);
    int md = cJSON_GetInt(pCfg, "md", -1);

    if (n >= 0 && n < BOARD_TCPIP_MAX && md >= TCP_IP_M_NORMAL && md < TCP_IP_M_NUM) {
        tcpip_cfg_t xBak = g_tcpip_cfgs[n];
        g_tcpip_cfgs[n].mode = md;
        if (en >= 0) g_tcpip_cfgs[n].enable = (en != 0 ? VAR_TRUE : VAR_FALSE);
        if (tt >= 0) g_tcpip_cfgs[n].tcpip_type = tt;
        if (cs >= 0) g_tcpip_cfgs[n].tcpip_cs = cs;
        if (pe && strlen(pe) < sizeof(g_tcpip_cfgs[n].peer)) {
            memset(&g_tcpip_cfgs[n].peer, 0, sizeof(g_tcpip_cfgs[n].peer)); strcpy(g_tcpip_cfgs[n].peer, pe);
        }
        if (po >= 0 && po <= 65535) g_tcpip_cfgs[n].port = po;
        if (it >= 0) g_tcpip_cfgs[n].interval = it;
        if (kl >= 0) g_tcpip_cfgs[n].keepalive = (kl != 0);
        
        if(TCP_IP_M_NORMAL == md) {
            cJSON *normal = cJSON_GetObjectItem(pCfg, "normal");
            if(normal) {
            
                int pt = cJSON_GetInt(normal, "pt", -1);
                int ms = cJSON_GetInt(normal, "ms", -1);
                int mad = cJSON_GetInt(normal, "mad", -1);
                
                if (pt >= 0) g_tcpip_cfgs[n].cfg.normal.proto_type = pt;
                if (ms >= 0) g_tcpip_cfgs[n].cfg.normal.proto_ms = ms;
                if (mad >= MB_ADDRESS_MIN && mad <= MB_ADDRESS_MAX) g_tcpip_cfgs[n].cfg.normal.maddress = mad;
            }
        } else if(TCP_IP_M_XFER == md) {
            cJSON *xfer = cJSON_GetObjectItem(pCfg, "xfer");
            if(xfer) {
                xfer_dst_uart_cfg *pucfg = RT_NULL;
                int xfer_md = cJSON_GetInt(xfer, "md", -1);
                if (xfer_md >= XFER_M_GW && xfer_md < XFER_M_NUM) {
                    g_tcpip_cfgs[n].cfg.xfer.mode = xfer_md;
                    int xfer_pt = cJSON_GetInt( xfer, "pt", -1 );
                    int xfer_dt = cJSON_GetInt( xfer, "dt", -1 );
                    int ubr = cJSON_GetInt( xfer, "ubr", -1 );
                    int udb = cJSON_GetInt( xfer, "udb", -1 );
                    int usb = cJSON_GetInt( xfer, "usb", -1 );
                    int upy = cJSON_GetInt( xfer, "upy", -1 );
                    
                    if(XFER_M_GW == xfer_md) {
                        if(xfer_pt >= 0) g_tcpip_cfgs[n].cfg.xfer.cfg.gw.proto_type = xfer_pt;
                        if(xfer_dt >= 0) g_tcpip_cfgs[n].cfg.xfer.cfg.gw.dst_type = xfer_dt;
                        if(xfer_dt>=PROTO_DEV_RS1 && xfer_dt<=PROTO_DEV_RS_MAX) {
                            pucfg = &g_tcpip_cfgs[n].cfg.xfer.cfg.gw.dst_cfg.uart_cfg;
                        }
                    } else if(XFER_M_TRT == xfer_md) {
                        if(xfer_dt >= 0) g_tcpip_cfgs[n].cfg.xfer.cfg.trt.dst_type = xfer_dt;
                        if(xfer_dt>=PROTO_DEV_RS1 && xfer_dt<=PROTO_DEV_RS_MAX) {
                            pucfg = &g_tcpip_cfgs[n].cfg.xfer.cfg.trt.dst_cfg.uart_cfg;
                        }
                    }
                    
                    if(pucfg) {
                        pucfg->type = g_uart_cfgs[nUartGetInstance(xfer_dt)].uart_type;
                        if( ubr >= 0 ) pucfg->cfg.baud_rate = ubr;
                        if( udb >= 0 ) pucfg->cfg.data_bits = udb;
                        if( usb >= 0 ) pucfg->cfg.stop_bits = usb;
                        if( upy >= 0 ) pucfg->cfg.parity    = upy;
                    }
                }
            }
        }

        if (memcmp(&xBak, &g_tcpip_cfgs[n], sizeof(tcpip_cfg_t)) != 0) {

            // 以太网, 阻塞方式重新配置需要重启

            // GPRS 可以即时生效

            // add by jay 2017/04/16 去除即时生效, 配置完需要重启
            prvSaveTcpipCfgsToFs();
        }
    }
}

DEF_CGI_HANDLER(setTcpipCfg)
{
    rt_err_t err = RT_EOK;
    const char *szJSON = CGI_GET_ARG("arg");
    cJSON *pCfg = szJSON ? cJSON_Parse(szJSON) : RT_NULL;
    if (pCfg) {
        setTcpipCfgWithJson(pCfg);
    } else {
        err = RT_ERROR;
    }
    cJSON_Delete(pCfg);

    WEBS_PRINTF("{\"ret\":%d}", err);
    WEBS_DONE(200);
}

void jsonTcpipCfg(int n, cJSON *pItem)
{
    if (n >= 0 && n < BOARD_TCPIP_MAX) {
        cJSON_AddNumberToObject(pItem, "n", n);
        cJSON_AddNumberToObject(pItem, "en", g_tcpip_cfgs[n].enable);
        cJSON_AddNumberToObject(pItem, "md", g_tcpip_cfgs[n].mode);
        cJSON_AddNumberToObject(pItem, "tt", g_tcpip_cfgs[n].tcpip_type);
        cJSON_AddNumberToObject(pItem, "cs", g_tcpip_cfgs[n].tcpip_cs);
        cJSON_AddStringToObject(pItem, "pe", g_tcpip_cfgs[n].peer);
        cJSON_AddNumberToObject(pItem, "po", g_tcpip_cfgs[n].port);
        cJSON_AddNumberToObject(pItem, "it", g_tcpip_cfgs[n].interval);
        cJSON_AddNumberToObject(pItem, "kl", g_tcpip_cfgs[n].keepalive ? 1 : 0);

        cJSON *cfg = cJSON_CreateObject();
        if(TCP_IP_M_NORMAL == g_tcpip_cfgs[n].mode) {
            cJSON_AddItemToObject(pItem, "normal", cfg);
            cJSON_AddNumberToObject(cfg, "pt", g_tcpip_cfgs[n].cfg.normal.proto_type);
            cJSON_AddNumberToObject(cfg, "ms", g_tcpip_cfgs[n].cfg.normal.proto_ms);
            cJSON_AddNumberToObject(cfg, "mad", g_tcpip_cfgs[n].cfg.normal.maddress);
        } else if(TCP_IP_M_XFER == g_tcpip_cfgs[n].mode) {
            xfer_dst_uart_cfg *pucfg = RT_NULL;
            cJSON_AddItemToObject(pItem, "xfer", cfg);
            cJSON_AddNumberToObject(cfg, "md", g_tcpip_cfgs[n].cfg.xfer.mode);
            if(XFER_M_GW == g_tcpip_cfgs[n].cfg.xfer.mode) {
                cJSON_AddNumberToObject(cfg, "pt", g_tcpip_cfgs[n].cfg.xfer.cfg.gw.proto_type);
                cJSON_AddNumberToObject(cfg, "dt", g_tcpip_cfgs[n].cfg.xfer.cfg.gw.dst_type);
                pucfg = &g_tcpip_cfgs[n].cfg.xfer.cfg.gw.dst_cfg.uart_cfg;
            } else if(XFER_M_TRT == g_tcpip_cfgs[n].cfg.xfer.mode) {
                cJSON_AddNumberToObject(cfg, "dt", g_tcpip_cfgs[n].cfg.xfer.cfg.trt.dst_type);
                pucfg = &g_tcpip_cfgs[n].cfg.xfer.cfg.trt.dst_cfg.uart_cfg;
            }

            if(pucfg) {
                cJSON_AddNumberToObject(cfg, "uty", pucfg->type);
                cJSON_AddNumberToObject(cfg, "ubr", pucfg->cfg.baud_rate);
                cJSON_AddNumberToObject(cfg, "udb", pucfg->cfg.data_bits);
                cJSON_AddNumberToObject(cfg, "usb", pucfg->cfg.stop_bits);
                cJSON_AddNumberToObject(cfg, "upy", pucfg->cfg.parity);
            }
        }
    }
}

DEF_CGI_HANDLER(getTcpipCfg)
{
    rt_err_t err = RT_EOK;
    const char *szJSON = CGI_GET_ARG("arg");
    cJSON *pCfg = szJSON ? cJSON_Parse(szJSON) : RT_NULL;
    char *szRetJSON = RT_NULL;

    if (pCfg) {
        int all = cJSON_GetInt(pCfg, "all", 0);
        if (all) {
            WEBS_PRINTF("{\"ret\":0,\"list\":[");
            rt_bool_t first = RT_TRUE;
            for (int n = 0; n < BOARD_TCPIP_MAX; n++) {
                cJSON *pItem = cJSON_CreateObject();
                if(pItem) {
                    if (!first) WEBS_PRINTF(",");
                    first = RT_FALSE;
                    jsonTcpipCfg(n, pItem);
                    szRetJSON = cJSON_PrintUnformatted(pItem);
                    if(szRetJSON) {
                        WEBS_PRINTF(szRetJSON);
                        rt_free(szRetJSON);
                    }
                }
                cJSON_Delete(pItem);
            }
            WEBS_PRINTF("]}");
        } else {
            int n = cJSON_GetInt(pCfg, "n", -1);
            if (n >= 0 && n < BOARD_TCPIP_MAX) {
                cJSON *pItem = cJSON_CreateObject();
                if(pItem) {
                    cJSON_AddNumberToObject(pItem, "ret", RT_EOK);
                    jsonTcpipCfg(n, pItem);
                    szRetJSON = cJSON_PrintUnformatted(pItem);
                    if(szRetJSON) {
                        WEBS_PRINTF(szRetJSON);
                        rt_free(szRetJSON);
                    }
                }
                cJSON_Delete(pItem);
            }
        }
    } else {
        err = RT_ERROR;
    }
    cJSON_Delete(pCfg);

    if (err != RT_EOK) {
        WEBS_PRINTF("{\"ret\":%d}", err);
    }
    WEBS_DONE(200);
}

void jsonTcpipState(int n, cJSON *pItem)
{
    if (n >= 0 && n < BOARD_TCPIP_MAX) {
        cJSON_AddNumberToObject(pItem, "en", g_tcpip_states[n].enable);
        cJSON_AddNumberToObject(pItem, "st", g_tcpip_states[n].eState);
        cJSON_AddStringToObject(pItem, "rip", g_tcpip_states[n].szRemIP);
        cJSON_AddNumberToObject(pItem, "rpt", g_tcpip_states[n].usRemPort);
        cJSON_AddStringToObject(pItem, "lip", g_tcpip_states[n].szLocIP);
        cJSON_AddNumberToObject(pItem, "lpt", g_tcpip_states[n].usLocPort);
        cJSON_AddNumberToObject(pItem, "tc", g_tcpip_states[n].ulConnTime);
        cJSON_AddNumberToObject(pItem, "tn", (rt_millisecond_from_tick(rt_tick_get())) / 1000);
    }
}

DEF_CGI_HANDLER(getTcpipState)
{
    rt_err_t err = RT_EOK;
    const char *szJSON = CGI_GET_ARG("arg");
    cJSON *pCfg = szJSON ? cJSON_Parse(szJSON) : RT_NULL;
    char *szRetJSON = RT_NULL;

    WEBS_PRINTF("{\"ret\":0,\"states\":[");
    rt_bool_t first = RT_TRUE;
    for (int n = 0; n < BOARD_TCPIP_MAX; n++) {
        cJSON *pItem = cJSON_CreateObject();
        if(pItem) {
            if (!first) WEBS_PRINTF(",");
            first = RT_FALSE;
            jsonTcpipState(n, pItem);
            szRetJSON = cJSON_PrintUnformatted(pItem);
            if(szRetJSON) {
                WEBS_PRINTF(szRetJSON);
                rt_free(szRetJSON);
            }
        }
        cJSON_Delete(pItem);
    }
    WEBS_PRINTF("]}");
    cJSON_Delete(pCfg);

    if (err != RT_EOK) {
        WEBS_PRINTF("{\"ret\":%d}", err);
    }
    WEBS_DONE(200);
}
