decomen/NXP-K64-gateway/software/RTU_Terminal/drivers/sx1278/sx1276-Fsk.c

/*
 * THE FOLLOWING FIRMWARE IS PROVIDED: (1) "AS IS" WITH NO WARRANTY; AND 
 * (2)TO ENABLE ACCESS TO CODING INFORMATION TO GUIDE AND FACILITATE CUSTOMER.
 * CONSEQUENTLY, SEMTECH SHALL NOT BE HELD LIABLE FOR ANY DIRECT, INDIRECT OR
 * CONSEQUENTIAL DAMAGES WITH RESPECT TO ANY CLAIMS ARISING FROM THE CONTENT
 * OF SUCH FIRMWARE AND/OR THE USE MADE BY CUSTOMERS OF THE CODING INFORMATION
 * CONTAINED HEREIN IN CONNECTION WITH THEIR PRODUCTS.
 * 
 * Copyright (C) SEMTECH S.A.
 */
/*! 
 * \file       sx1276.c
 * \brief      SX1276 RF chip driver
 *
 * \version    2.0.0 
 * \date       May 6 2013
 * \author     Gregory Cristian
 *
 * Last modified by Miguel Luis on Jun 19 2013
 */
#include <string.h>
#include <math.h>

//#include "platform.h"


#include "radio.h"

#include "sx1276-Hal.h"
#include "sx1276.h"

#include "sx1276-FskMisc.h"
#include "sx1276-Fsk.h"

// Default settings
tFskSettings FskSettings = 
{
    870000000,      // RFFrequency
    9600,           // Bitrate
    50000,          // Fdev
    20,             // Power
    100000,         // RxBw
    150000,         // RxBwAfc
    true,           // CrcOn
    true,           // AfcOn    
    255             // PayloadLength (set payload size to the maximum for variable mode, else set the exact payload length)
};

/*!
 * SX1276 FSK registers variable
 */
tSX1276* SX1276;

/*!
 * Local RF buffer for communication support
 */
static uint8_t RFBuffer[RF_BUFFER_SIZE];

/*!
 * Chunk size of data write in buffer 
 */
static uint8_t DataChunkSize = 32;


/*!
 * RF state machine variable
 */
static uint8_t RFState = RF_STATE_IDLE;

/*!
 * Rx management support variables
 */

/*!
 * PacketTimeout holds the RF packet timeout
 * SyncSize = [0..8]
 * VariableSize = [0;1]
 * AddressSize = [0;1]
 * PayloadSize = [0..RF_BUFFER_SIZE]
 * CrcSize = [0;2]
 * PacketTimeout = ( ( 8 * ( VariableSize + AddressSize + PayloadSize + CrcSize ) / BR ) * 1000.0 ) + 1
 * Computed timeout is in miliseconds
 */
static uint32_t PacketTimeout;

/*!
 * Preamble2SyncTimeout
 * Preamble2SyncTimeout = ( ( 8 * ( PremableSize + SyncSize ) / RFBitrate ) * 1000.0 ) + 1
 * Computed timeout is in miliseconds
 */
static uint32_t Preamble2SyncTimeout;

static bool PreambleDetected = false;
static bool SyncWordDetected = false;
static bool PacketDetected = false;
static uint16_t RxPacketSize = 0;
static uint8_t RxBytesRead = 0;
static uint8_t TxBytesSent = 0;
static double RxPacketRssiValue;
static uint32_t RxPacketAfcValue;
static uint8_t RxGain = 1;
static uint32_t RxTimeoutTimer = 0;
static uint32_t Preamble2SyncTimer = 0;

/*!
 * Tx management support variables
 */
static uint16_t TxPacketSize = 0;
static uint32_t TxTimeoutTimer = 0;

void SX1276FskInit( void )
{
    RFState = RF_STATE_IDLE;

    SX1276FskSetDefaults( );
    
    SX1276ReadBuffer( REG_OPMODE, SX1276Regs + 1, 0x70 - 1 );

    // Set the device in FSK mode and Sleep Mode
    SX1276->RegOpMode = RF_OPMODE_MODULATIONTYPE_FSK | RF_OPMODE_SLEEP;
    SX1276Write( REG_OPMODE, SX1276->RegOpMode );

    SX1276->RegPaRamp = RF_PARAMP_MODULATIONSHAPING_01;
    SX1276Write( REG_PARAMP, SX1276->RegPaRamp );

    SX1276->RegLna = RF_LNA_GAIN_G1;
    SX1276Write( REG_LNA, SX1276->RegLna );

    if( FskSettings.AfcOn == true )
    {
        SX1276->RegRxConfig = RF_RXCONFIG_RESTARTRXONCOLLISION_OFF | RF_RXCONFIG_AFCAUTO_ON |
                              RF_RXCONFIG_AGCAUTO_ON | RF_RXCONFIG_RXTRIGER_PREAMBLEDETECT;
    }
    else
    {
        SX1276->RegRxConfig = RF_RXCONFIG_RESTARTRXONCOLLISION_OFF | RF_RXCONFIG_AFCAUTO_OFF |
                              RF_RXCONFIG_AGCAUTO_ON | RF_RXCONFIG_RXTRIGER_PREAMBLEDETECT;
    }

    SX1276->RegPreambleLsb = 8;
    
    SX1276->RegPreambleDetect = RF_PREAMBLEDETECT_DETECTOR_ON | RF_PREAMBLEDETECT_DETECTORSIZE_2 |
                                RF_PREAMBLEDETECT_DETECTORTOL_10;

    SX1276->RegRssiThresh = 0xFF;

    SX1276->RegSyncConfig = RF_SYNCCONFIG_AUTORESTARTRXMODE_WAITPLL_ON | RF_SYNCCONFIG_PREAMBLEPOLARITY_AA |
                            RF_SYNCCONFIG_SYNC_ON |
                            RF_SYNCCONFIG_SYNCSIZE_4;

    SX1276->RegSyncValue1 = 0x69;
    SX1276->RegSyncValue2 = 0x81;
    SX1276->RegSyncValue3 = 0x7E;
    SX1276->RegSyncValue4 = 0x96;

    SX1276->RegPacketConfig1 = RF_PACKETCONFIG1_PACKETFORMAT_VARIABLE | RF_PACKETCONFIG1_DCFREE_OFF |
                               ( FskSettings.CrcOn << 4 ) | RF_PACKETCONFIG1_CRCAUTOCLEAR_ON |
                               RF_PACKETCONFIG1_ADDRSFILTERING_OFF | RF_PACKETCONFIG1_CRCWHITENINGTYPE_CCITT;
    SX1276FskGetPacketCrcOn( ); // Update CrcOn on FskSettings

    SX1276->RegPayloadLength = FskSettings.PayloadLength;

    // we can now update the registers with our configuration
    SX1276WriteBuffer( REG_OPMODE, SX1276Regs + 1, 0x70 - 1 );

    // then we need to set the RF settings 
    SX1276FskSetRFFrequency( FskSettings.RFFrequency );
    SX1276FskSetBitrate( FskSettings.Bitrate );
    SX1276FskSetFdev( FskSettings.Fdev );

    SX1276FskSetDccBw( &SX1276->RegRxBw, 0, FskSettings.RxBw );
    SX1276FskSetDccBw( &SX1276->RegAfcBw, 0, FskSettings.RxBwAfc );
    SX1276FskSetRssiOffset( 0 );

#if( ( MODULE_SX1276RF1IAS == 1 ) || ( MODULE_SX1276RF1KAS == 1 ) )
    if( FskSettings.RFFrequency > 860000000 )
    {
        SX1276FskSetPAOutput( RF_PACONFIG_PASELECT_RFO );
        SX1276FskSetPa20dBm( false );
        FskSettings.Power = 14;
        SX1276FskSetRFPower( FskSettings.Power );
    }
    else
    {
        SX1276FskSetPAOutput( RF_PACONFIG_PASELECT_PABOOST );
        SX1276FskSetPa20dBm( true );
        FskSettings.Power = 20;
        SX1276FskSetRFPower( FskSettings.Power );
    } 
#elif( MODULE_SX1276RF1JAS == 1 )
    if( FskSettings.RFFrequency > 860000000 )
    {
        SX1276FskSetPAOutput( RF_PACONFIG_PASELECT_PABOOST );
        SX1276FskSetPa20dBm( true );
        FskSettings.Power = 20;
        SX1276FskSetRFPower( FskSettings.Power );
    }
    else
    {
        SX1276FskSetPAOutput( RF_PACONFIG_PASELECT_RFO );
        SX1276FskSetPa20dBm( false );
        FskSettings.Power = 14;
        SX1276FskSetRFPower( FskSettings.Power );
    } 
#endif

    SX1276FskSetOpMode( RF_OPMODE_STANDBY );

    // Calibrate the HF
    SX1276FskRxCalibrate( );
}

void SX1276FskSetDefaults( void )
{
    // REMARK: See SX1276 datasheet for modified default values.

    SX1276Read( REG_VERSION, &SX1276->RegVersion );
}

void SX1276FskSetOpMode( uint8_t opMode )
{
    static uint8_t opModePrev = RF_OPMODE_STANDBY;
    static bool antennaSwitchTxOnPrev = true;
    bool antennaSwitchTxOn = false;

    opModePrev = SX1276->RegOpMode & ~RF_OPMODE_MASK;

    if( opMode != opModePrev )
    {
        if( opMode == RF_OPMODE_TRANSMITTER )
        {
            antennaSwitchTxOn = true;
        }
        else
        {
            antennaSwitchTxOn = false;
        }
        if( antennaSwitchTxOn != antennaSwitchTxOnPrev )
        {
            antennaSwitchTxOnPrev = antennaSwitchTxOn;
            RXTX( antennaSwitchTxOn ); // Antenna switch control
        }
        SX1276->RegOpMode = ( SX1276->RegOpMode & RF_OPMODE_MASK ) | opMode;

        SX1276Write( REG_OPMODE, SX1276->RegOpMode );        
    }
}

uint8_t SX1276FskGetOpMode( void )
{
    SX1276Read( REG_OPMODE, &SX1276->RegOpMode );
    
    return SX1276->RegOpMode & ~RF_OPMODE_MASK;
}

int32_t SX1276FskReadFei( void )
{
    SX1276ReadBuffer( REG_FEIMSB, &SX1276->RegFeiMsb, 2 );                          // Reads the FEI value

    return ( int32_t )( double )( ( ( uint16_t )SX1276->RegFeiMsb << 8 ) | ( uint16_t )SX1276->RegFeiLsb ) * ( double )FREQ_STEP;
}

int32_t SX1276FskReadAfc( void )
{
    SX1276ReadBuffer( REG_AFCMSB, &SX1276->RegAfcMsb, 2 );                            // Reads the AFC value
    return ( int32_t )( double )( ( ( uint16_t )SX1276->RegAfcMsb << 8 ) | ( uint16_t )SX1276->RegAfcLsb ) * ( double )FREQ_STEP;
}

uint8_t SX1276FskReadRxGain( void )
{
    SX1276Read( REG_LNA, &SX1276->RegLna );
    return( SX1276->RegLna >> 5 ) & 0x07;
}

double SX1276FskReadRssi( void )
{
    SX1276Read( REG_RSSIVALUE, &SX1276->RegRssiValue );                               // Reads the RSSI value

    return -( double )( ( double )SX1276->RegRssiValue / 2.0 );
}

uint8_t SX1276FskGetPacketRxGain( void )
{
    return RxGain;
}

double SX1276FskGetPacketRssi( void )
{
    return RxPacketRssiValue;
}

uint32_t SX1276FskGetPacketAfc( void )
{
    return RxPacketAfcValue;
}

void SX1276FskStartRx( void )
{
    SX1276FskSetRFState( RF_STATE_RX_INIT );
}

void SX1276FskGetRxPacket( void *buffer, uint16_t *size )
{
    *size = RxPacketSize;
    RxPacketSize = 0;
    memcpy( ( void * )buffer, ( void * )RFBuffer, ( size_t )*size );
}

void SX1276FskSetTxPacket( const void *buffer, uint16_t size )
{
    TxPacketSize = size;
    memcpy( ( void * )RFBuffer, buffer, ( size_t )TxPacketSize ); 

    RFState = RF_STATE_TX_INIT;
}

// Remark: SX1276 must be fully initialized before calling this function
uint16_t SX1276FskGetPacketPayloadSize( void )
{
    uint16_t syncSize;
    uint16_t variableSize;
    uint16_t addressSize;
    uint16_t payloadSize;
    uint16_t crcSize;

    syncSize = ( SX1276->RegSyncConfig & 0x07 ) + 1;
    variableSize = ( ( SX1276->RegPacketConfig1 & 0x80 ) == 0x80 ) ? 1 : 0;
    addressSize = ( ( SX1276->RegPacketConfig1 & 0x06 ) != 0x00 ) ? 1 : 0;
    payloadSize = SX1276->RegPayloadLength;
    crcSize = ( ( SX1276->RegPacketConfig1 & 0x10 ) == 0x10 ) ? 2 : 0;
    
    return syncSize + variableSize + addressSize + payloadSize + crcSize;
}

// Remark: SX1276 must be fully initialized before calling this function
uint16_t SX1276FskGetPacketHeaderSize( void )
{
    uint16_t preambleSize;
    uint16_t syncSize;

    preambleSize = ( ( uint16_t )SX1276->RegPreambleMsb << 8 ) | ( uint16_t )SX1276->RegPreambleLsb;
    syncSize = ( SX1276->RegSyncConfig & 0x07 ) + 1;
    
    return preambleSize + syncSize;
}

uint8_t SX1276FskGetRFState( void )
{
    return RFState;
}

void SX1276FskSetRFState( uint8_t state )
{
    RFState = state;
}


static uint8_t FskReadIoModeReady()
{
	SX1276Read( REG_IRQFLAGS1, &SX1276->RegIrqFlags1);
	return ( (SX1276->RegIrqFlags1 & RF_IRQFLAGS1_MODEREADY) == RF_IRQFLAGS1_MODEREADY);
}

static uint8_t FskReadIoRxReady()
{
	SX1276Read( REG_IRQFLAGS1, &SX1276->RegIrqFlags1);
	return ( (SX1276->RegIrqFlags1 & RF_IRQFLAGS1_RXREADY) == RF_IRQFLAGS1_RXREADY);
}

static uint8_t FskReadIoTxReady()
{
	SX1276Read( REG_IRQFLAGS1, &SX1276->RegIrqFlags1);
	return ( (SX1276->RegIrqFlags1 & RF_IRQFLAGS1_TXREADY) == RF_IRQFLAGS1_TXREADY);
}
static uint8_t FskReadIoPllLock()
{
	SX1276Read( REG_IRQFLAGS1, &SX1276->RegIrqFlags1);
	return ( (SX1276->RegIrqFlags1 & RF_IRQFLAGS1_PLLLOCK) == RF_IRQFLAGS1_PLLLOCK);
}
static uint8_t FskReadIoRssi()
{
	SX1276Read( REG_IRQFLAGS1, &SX1276->RegIrqFlags1);
	return ( (SX1276->RegIrqFlags1 & RF_IRQFLAGS1_RSSI) == RF_IRQFLAGS1_RSSI);
}
static uint8_t FskReadIoTimeout()
{
	SX1276Read( REG_IRQFLAGS1, &SX1276->RegIrqFlags1);
	return ( (SX1276->RegIrqFlags1 & RF_IRQFLAGS1_TIMEOUT) == RF_IRQFLAGS1_TIMEOUT);
}

//当前导码检测器检测到有效 前导码时设置该位。设置为1 时，清除该位。
static uint8_t FskReadIoPreambleDetech()  // 
{
	SX1276Read( REG_IRQFLAGS1, &SX1276->RegIrqFlags1);
	return ( (SX1276->RegIrqFlags1 & RF_IRQFLAGS1_PREAMBLEDETECT) == RF_IRQFLAGS1_PREAMBLEDETECT);
}

//检测到Sync 和Address（如果启动）时，设置该位。

static uint8_t FskReadIoSyncAddressMatch()
{
	SX1276Read( REG_IRQFLAGS1, &SX1276->RegIrqFlags1);
	return ( (SX1276->RegIrqFlags1 & RF_IRQFLAGS1_SYNCADDRESSMATCH) == RF_IRQFLAGS1_SYNCADDRESSMATCH);
}

/*========== REG_IRQFLAGS2 ==========*/

static uint8_t FskReadIoFifoFull()
{
	SX1276Read( REG_IRQFLAGS2, &SX1276->RegIrqFlags2);
	return ( (SX1276->RegIrqFlags2 & RF_IRQFLAGS2_FIFOFULL) == RF_IRQFLAGS2_FIFOFULL);
}

static uint8_t FskReadIoFifoEmpty()
{
	SX1276Read( REG_IRQFLAGS2, &SX1276->RegIrqFlags2);
	return ( (SX1276->RegIrqFlags2 & RF_IRQFLAGS2_FIFOEMPTY) == RF_IRQFLAGS2_FIFOEMPTY);
}
static uint8_t FskReadIoFifoLevel()
{
	SX1276Read( REG_IRQFLAGS2, &SX1276->RegIrqFlags2);
	return ( (SX1276->RegIrqFlags2 & RF_IRQFLAGS2_FIFOLEVEL) == RF_IRQFLAGS2_FIFOLEVEL);
}
static uint8_t FskReadIoFifoOverrun()
{
	SX1276Read( REG_IRQFLAGS2, &SX1276->RegIrqFlags2);
	return ( (SX1276->RegIrqFlags2 & RF_IRQFLAGS2_FIFOOVERRUN) == RF_IRQFLAGS2_FIFOOVERRUN);
}
static uint8_t FskReadIoPacketSent()
{
	SX1276Read( REG_IRQFLAGS2, &SX1276->RegIrqFlags2);
	return ( (SX1276->RegIrqFlags2 & RF_IRQFLAGS2_PACKETSENT) == RF_IRQFLAGS2_PACKETSENT);
}
static uint8_t FskReadIoPayloadReady()
{
	SX1276Read( REG_IRQFLAGS2, &SX1276->RegIrqFlags2);
	return ( (SX1276->RegIrqFlags2 & RF_IRQFLAGS2_PAYLOADREADY) == RF_IRQFLAGS2_PAYLOADREADY);
}
static uint8_t FskReadIoCrcOk()
{
	SX1276Read( REG_IRQFLAGS2, &SX1276->RegIrqFlags2);
	return ( (SX1276->RegIrqFlags2 & RF_IRQFLAGS2_CRCOK) == RF_IRQFLAGS2_CRCOK);
}
static uint8_t FskReadIoLowBat()
{
	SX1276Read( REG_IRQFLAGS2, &SX1276->RegIrqFlags2);
	return ( (SX1276->RegIrqFlags2 & RF_IRQFLAGS2_LOWBAT) == RF_IRQFLAGS2_LOWBAT);
}

uint32_t SX1276FskProcess( void )
{
    uint32_t result = RF_BUSY;

    switch( RFState )
    {
    case RF_STATE_IDLE:
        break;
    // Rx management
    case RF_STATE_RX_INIT:
        // DIO mapping setup
        if( ( SX1276->RegPacketConfig1 & RF_PACKETCONFIG1_CRC_ON ) == RF_PACKETCONFIG1_CRC_ON )
        {
            //                           CrcOk,                   FifoLevel,               SyncAddr,               FifoEmpty
            SX1276->RegDioMapping1 = RF_DIOMAPPING1_DIO0_01 | RF_DIOMAPPING1_DIO1_00 | RF_DIOMAPPING1_DIO2_11 | RF_DIOMAPPING1_DIO3_00;
        }
        else
        {
            //                           PayloadReady,            FifoLevel,               SyncAddr,               FifoEmpty
            SX1276->RegDioMapping1 = RF_DIOMAPPING1_DIO0_00 | RF_DIOMAPPING1_DIO1_00 | RF_DIOMAPPING1_DIO2_11 | RF_DIOMAPPING1_DIO3_00;
        }
        //                          Preamble,                   Data
        SX1276->RegDioMapping2 = RF_DIOMAPPING2_DIO4_11 | RF_DIOMAPPING2_DIO5_10 | RF_DIOMAPPING2_MAP_PREAMBLEDETECT;
        SX1276WriteBuffer( REG_DIOMAPPING1, &SX1276->RegDioMapping1, 2 );

        SX1276FskSetOpMode( RF_OPMODE_RECEIVER );
    
        memset( RFBuffer, 0, ( size_t )RF_BUFFER_SIZE );

        PacketTimeout = ( uint16_t )( round( ( 8.0 * ( ( double )SX1276FskGetPacketPayloadSize( ) ) / ( double )FskSettings.Bitrate ) * 1000.0 ) + 1.0 );
        PacketTimeout = PacketTimeout + ( PacketTimeout >> 1 ); // Set the Packet timeout as 1.5 times the full payload transmission time

        Preamble2SyncTimeout = PacketTimeout;

        Preamble2SyncTimer = RxTimeoutTimer = GET_TICK_COUNT( );

        SX1276->RegFifoThresh = RF_FIFOTHRESH_TXSTARTCONDITION_FIFONOTEMPTY | 0x20; // 32 bytes of data
        SX1276Write( REG_FIFOTHRESH, SX1276->RegFifoThresh );

        PreambleDetected = false;
        SyncWordDetected = false;
        PacketDetected = false;
        RxBytesRead = 0;
        RxPacketSize = 0;
        RFState = RF_STATE_RX_SYNC;
        break;
    case RF_STATE_RX_SYNC:
        if( ( FskReadIoPreambleDetech()/*DIO4 == 1*/ ) && ( PreambleDetected == false ) )// Preamble
        {
            PreambleDetected = true;
            Preamble2SyncTimer = GET_TICK_COUNT( );

			 SX1276Write( REG_IRQFLAGS1, RF_IRQFLAGS1_PREAMBLEDETECT  );
        }
        if( (FskReadIoSyncAddressMatch() /*DIO2 == 1*/ ) && ( PreambleDetected == true ) && ( SyncWordDetected == false ) ) // SyncAddr
        {
            SyncWordDetected = true;
        
            RxPacketRssiValue = SX1276FskReadRssi( );

            RxPacketAfcValue = SX1276FskReadAfc( );
            RxGain = SX1276FskReadRxGain( );
        
            Preamble2SyncTimer = RxTimeoutTimer = GET_TICK_COUNT( );

            RFState = RF_STATE_RX_RUNNING;
        }

        // Preamble 2 SyncAddr timeout
        if( ( SyncWordDetected == false ) && ( PreambleDetected == true ) && ( ( GET_TICK_COUNT( ) - Preamble2SyncTimer ) > Preamble2SyncTimeout ) )
        {
            RFState = RF_STATE_RX_INIT;
            SX1276Write( REG_RXCONFIG, SX1276->RegRxConfig | RF_RXCONFIG_RESTARTRXWITHPLLLOCK );
        }
        if( ( SyncWordDetected == false ) &&
            ( PreambleDetected == false ) &&
            ( PacketDetected == false ) &&
            ( ( GET_TICK_COUNT( ) - RxTimeoutTimer ) > PacketTimeout ) )
        {
            RFState = RF_STATE_RX_TIMEOUT;
        }
        break;
    case RF_STATE_RX_RUNNING:
        if( RxPacketSize > RF_BUFFER_SIZE_MAX )
        {
            RFState = RF_STATE_RX_LEN_ERROR;
            break;
        }
#if 1
        if( FskReadIoFifoLevel() /*DIO1 == 1*/ ) // FifoLevel
        {
            if( ( RxPacketSize == 0 ) && ( RxBytesRead == 0 ) ) // Read received packet size
            {
                if( ( SX1276->RegPacketConfig1 & RF_PACKETCONFIG1_PACKETFORMAT_VARIABLE ) == RF_PACKETCONFIG1_PACKETFORMAT_VARIABLE )
                {
                    SX1276ReadFifo( ( uint8_t* )&RxPacketSize, 1 );
                }
                else
                {
                    RxPacketSize = SX1276->RegPayloadLength;
                }
            }

            if( ( RxPacketSize - RxBytesRead ) > ( SX1276->RegFifoThresh & 0x3F ) )
            {
                SX1276ReadFifo( ( RFBuffer + RxBytesRead ), ( SX1276->RegFifoThresh & 0x3F ) );
                RxBytesRead += ( SX1276->RegFifoThresh & 0x3F );
            }
            else
            {
                SX1276ReadFifo( ( RFBuffer + RxBytesRead ), RxPacketSize - RxBytesRead );
                RxBytesRead += ( RxPacketSize - RxBytesRead );
            }
        }
#endif
        if( /* FskReadIoPayloadReady()*/ DIO0 == 1 ) // PayloadReady/CrcOk
        {
            RxTimeoutTimer = GET_TICK_COUNT( );
            if( ( RxPacketSize == 0 ) && ( RxBytesRead == 0 ) ) // Read received packet size
            {
                if( ( SX1276->RegPacketConfig1 & RF_PACKETCONFIG1_PACKETFORMAT_VARIABLE ) == RF_PACKETCONFIG1_PACKETFORMAT_VARIABLE )
                {
                    SX1276ReadFifo( ( uint8_t* )&RxPacketSize, 1 );
                }
                else
                {
                    RxPacketSize = SX1276->RegPayloadLength;
                }
                SX1276ReadFifo( RFBuffer + RxBytesRead, RxPacketSize - RxBytesRead );
                RxBytesRead += ( RxPacketSize - RxBytesRead );
                PacketDetected = true;
                RFState = RF_STATE_RX_DONE;
            }
            else
            {
                SX1276ReadFifo( RFBuffer + RxBytesRead, RxPacketSize - RxBytesRead );
                RxBytesRead += ( RxPacketSize - RxBytesRead );
                PacketDetected = true;
                RFState = RF_STATE_RX_DONE;
            }
        }
        
        // Packet timeout
        if( ( PacketDetected == false ) && ( ( GET_TICK_COUNT( ) - RxTimeoutTimer ) > PacketTimeout ) )
        {
            RFState = RF_STATE_RX_TIMEOUT;
        }
        break;
    case RF_STATE_RX_DONE:
        RxBytesRead = 0;
        RFState = RF_STATE_RX_INIT;
        result = RF_RX_DONE;
        break;
    case RF_STATE_RX_TIMEOUT:
        RxBytesRead = 0;
        RxPacketSize = 0;
        SX1276Write( REG_RXCONFIG, SX1276->RegRxConfig | RF_RXCONFIG_RESTARTRXWITHPLLLOCK );
        RFState = RF_STATE_RX_INIT;
        result = RF_RX_TIMEOUT;
        break;
    case RF_STATE_RX_LEN_ERROR:
        RxBytesRead = 0;
        RxPacketSize = 0;
        SX1276Write( REG_RXCONFIG, SX1276->RegRxConfig | RF_RXCONFIG_RESTARTRXWITHPLLLOCK );
        RFState = RF_STATE_RX_INIT;
        result = RF_LEN_ERROR;
        break;
    // Tx management
    case RF_STATE_TX_INIT:
        // Packet DIO mapping setup
        //                           PacketSent,               FifoLevel,              FifoFull,               TxReady
        SX1276->RegDioMapping1 = RF_DIOMAPPING1_DIO0_00 | RF_DIOMAPPING1_DIO1_00 | RF_DIOMAPPING1_DIO2_00 | RF_DIOMAPPING1_DIO3_01;
        //                           LowBat,                   Data
        SX1276->RegDioMapping2 = RF_DIOMAPPING2_DIO4_00 | RF_DIOMAPPING2_DIO5_10;
        SX1276WriteBuffer( REG_DIOMAPPING1, &SX1276->RegDioMapping1, 2 );

        SX1276->RegFifoThresh = RF_FIFOTHRESH_TXSTARTCONDITION_FIFONOTEMPTY | 0x18; // 24 bytes of data
        SX1276Write( REG_FIFOTHRESH, SX1276->RegFifoThresh );

        SX1276FskSetOpMode( RF_OPMODE_TRANSMITTER );
        RFState = RF_STATE_TX_READY_WAIT;
        TxBytesSent = 0;
        break;
    case RF_STATE_TX_READY_WAIT:
        if( FskReadIoTxReady() /* DIO3 == 1*/ )    // TxReady
        {
            if( ( SX1276->RegPacketConfig1 & RF_PACKETCONFIG1_PACKETFORMAT_VARIABLE ) == RF_PACKETCONFIG1_PACKETFORMAT_VARIABLE )
            {
                SX1276WriteFifo( ( uint8_t* )&TxPacketSize, 1 );
            }
            
            if( ( TxPacketSize > 0 ) && ( TxPacketSize <= 64 ) )
            {
                DataChunkSize = TxPacketSize;
            }
            else
            {
                DataChunkSize = 32;
            }
            
            SX1276WriteFifo( RFBuffer, DataChunkSize );
            TxBytesSent += DataChunkSize;
            TxTimeoutTimer = GET_TICK_COUNT( );
            RFState = RF_STATE_TX_RUNNING;
        }
        break;

    case RF_STATE_TX_RUNNING:
        if( FskReadIoFifoLevel() /*DIO1 == 0*/ )    // FifoLevel below thresold
        {  
            if( ( TxPacketSize - TxBytesSent ) > DataChunkSize )
            {
                SX1276WriteFifo( ( RFBuffer + TxBytesSent ), DataChunkSize );
                TxBytesSent += DataChunkSize;
            }
            else 
            {
                // we write the last chunk of data
                SX1276WriteFifo( RFBuffer + TxBytesSent, TxPacketSize - TxBytesSent );
                TxBytesSent += TxPacketSize - TxBytesSent;
            }
        }

        if( DIO0 == 1 ) // PacketSent
        {
            TxTimeoutTimer = GET_TICK_COUNT( );
            RFState = RF_STATE_TX_DONE;
            SX1276FskSetOpMode( RF_OPMODE_STANDBY );
        }
         
        // Packet timeout
        if( ( GET_TICK_COUNT( ) - TxTimeoutTimer ) > TICK_RATE_MS( 1000 ) )
        {
            RFState = RF_STATE_TX_TIMEOUT;
        }
        break;
    case RF_STATE_TX_DONE:
        RFState = RF_STATE_IDLE;
        result = RF_TX_DONE;
        break;
    case RF_STATE_TX_TIMEOUT:
        RFState = RF_STATE_IDLE;
        result = RF_TX_TIMEOUT;
        break;
    default:
        break;
    }
    return result;
}

//#endif // USE_SX1276_RADIO
