decomen/NXP-K64-gateway/software/RTU_Terminal/drivers/sx1278/sx1276-LoRa.c

/*
 * THE FOLLOWING FIRMWARE IS PROVIDED: (1) "AS IS" WITH NO WARRANTY; AND 
 * (2)TO ENABLE ACCESS TO CODING INFORMATION TO GUIDE AND FACILITATE CUSTOMER.
 * CONSEQUENTLY, SEMTECH SHALL NOT BE HELD LIABLE FOR ANY DIRECT, INDIRECT OR
 * CONSEQUENTIAL DAMAGES WITH RESPECT TO ANY CLAIMS ARISING FROM THE CONTENT
 * OF SUCH FIRMWARE AND/OR THE USE MADE BY CUSTOMERS OF THE CODING INFORMATION
 * CONTAINED HEREIN IN CONNECTION WITH THEIR PRODUCTS.
 * 
 * Copyright (C) SEMTECH S.A.
 */
/*! 
 * \file       sx1276-LoRa.c
 * \brief      SX1276 RF chip driver mode LoRa
 *
 * \version    2.0.0 
 * \date       May 6 2013
 * \author     Gregory Cristian
 *
 * Last modified by Miguel Luis on Jun 19 2013
 */
#include <string.h>



#include "radio.h"

#include "sx1276-Hal.h"
#include "sx1276.h"

#include "sx1276-LoRaMisc.h"
#include "sx1276-LoRa.h"

#define LoRa_FREQENCY   435000000

/*!
 * Constant values need to compute the RSSI value
 */
#define RSSI_OFFSET_LF                              -155.0
#define RSSI_OFFSET_HF                              -150.0

#define NOISE_ABSOLUTE_ZERO                         -174.0

#define NOISE_FIGURE_LF                                4.0
#define NOISE_FIGURE_HF                                6.0 

/*!
 * Precomputed signal bandwidth log values
 * Used to compute the Packet RSSI value.
 */
const double SignalBwLog[] =
{
    3.8927900303521316335038277369285,  // 7.8 kHz
    4.0177301567005500940384239336392,  // 10.4 kHz
    4.193820026016112828717566631653,   // 15.6 kHz
    4.31875866931372901183597627752391, // 20.8 kHz
    4.4948500216800940239313055263775,  // 31.2 kHz
    4.6197891057238405255051280399961,  // 41.6 kHz
    4.795880017344075219145044421102,   // 62.5 kHz
    5.0969100130080564143587833158265,  // 125 kHz
    5.397940008672037609572522210551,   // 250 kHz
    5.6989700043360188047862611052755   // 500 kHz
};

const double RssiOffsetLF[] =
{   // These values need to be specify in the Lab
    -155.0,
    -155.0,
    -155.0,
    -155.0,
    -155.0,
    -155.0,
    -155.0,
    -155.0,
    -155.0,
    -155.0,
};

const double RssiOffsetHF[] =
{   // These values need to be specify in the Lab
    -150.0,
    -150.0,
    -150.0,
    -150.0,
    -150.0,
    -150.0,
    -150.0,
    -150.0,
    -150.0,
    -150.0,
};

/*!
 * Frequency hopping frequencies table
 */
const int32_t HoppingFrequencies[] =
{
    916500000,
    923500000,
    906500000,
    917500000,
    917500000,
    909000000,
    903000000,
    916000000,
    912500000,
    926000000,
    925000000,
    909500000,
    913000000,
    918500000,
    918500000,
    902500000,
    911500000,
    926500000,
    902500000,
    922000000,
    924000000,
    903500000,
    913000000,
    922000000,
    926000000,
    910000000,
    920000000,
    922500000,
    911000000,
    922000000,
    909500000,
    926000000,
    922000000,
    918000000,
    925500000,
    908000000,
    917500000,
    926500000,
    908500000,
    916000000,
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
};

// Default settings
tLoRaSettings LoRaSettings =
{
    LoRa_FREQENCY ,     //435000000,        // RFFrequency
    20,               // Power
    8,                // SignalBw [0: 7.8kHz, 1: 10.4 kHz, 2: 15.6 kHz, 3: 20.8 kHz, 4: 31.2 kHz,
                      // 5: 41.6 kHz, 6: 62.5 kHz, 7: 125 kHz, 8: 250 kHz, 9: 500 kHz, other: Reserved]
    7,                // SpreadingFactor [6: 64, 7: 128, 8: 256, 9: 512, 10: 1024, 11: 2048, 12: 4096  chips]
    2,                // ErrorCoding [1: 4/5, 2: 4/6, 3: 4/7, 4: 4/8]
    true,             // CrcOn [0: OFF, 1: ON]
    false,            // ImplicitHeaderOn [0: OFF, 1: ON]
    0,                // RxSingleOn [0: Continuous, 1 Single]
    0,                // FreqHopOn [0: OFF, 1: ON]              //跳频技术
    4,                // HopPeriod Hops every frequency hopping period symbols
    100,              // TxPacketTimeout
    100,              // RxPacketTimeout
    128,              // PayloadLength (used for implicit header mode)
};

/*!
 * SX1276 LoRa registers variable
 */
tSX1276LR* SX1276LR;

/*!
 * Local RF buffer for communication support
 */
static uint8_t RFBuffer[RF_BUFFER_SIZE];

/*!
 * RF state machine variable
 */
static uint8_t RFLRState = RFLR_STATE_IDLE;

/*!
 * Rx management support variables
 */
static uint16_t RxPacketSize = 0;
static int8_t RxPacketSnrEstimate;
static double RxPacketRssiValue;
static uint8_t RxGain = 1;
static uint32_t RxTimeoutTimer = 0;
/*!
 * PacketTimeout Stores the Rx window time value for packet reception
 */
static uint32_t PacketTimeout;

/*!
 * Tx management support variables
 */
static uint16_t TxPacketSize = 0;

void SX1276LoRaInit( void )
{
    RFLRState = RFLR_STATE_IDLE;

    SX1276LoRaSetDefaults( );
    
	// We first load the device register structure with the default value (read from the device)
    SX1276ReadBuffer( REG_LR_OPMODE, SX1276Regs + 1, 0x70 - 1 );
    
//	// Set the device in Sleep Mode
//    SX1276LoRaSetOpMode( RFLR_OPMODE_SLEEP );
	
    SX1276LR->RegLna = RFLR_LNA_GAIN_G1;

    SX1276WriteBuffer( REG_LR_OPMODE, SX1276Regs + 1, 0x70 - 1 );

    // set the RF settings 
    SX1276LoRaSetRFFrequency( LoRaSettings.RFFrequency );         //set frequency
    SX1276LoRaSetSpreadingFactor( LoRaSettings.SpreadingFactor ); // SF6 only operates in implicit header mode.
    SX1276LoRaSetErrorCoding( LoRaSettings.ErrorCoding );
    SX1276LoRaSetPacketCrcOn( LoRaSettings.CrcOn );
    SX1276LoRaSetSignalBandwidth( LoRaSettings.SignalBw );

    SX1276LoRaSetImplicitHeaderOn( LoRaSettings.ImplicitHeaderOn );
    SX1276LoRaSetSymbTimeout( 0x3FF );
    SX1276LoRaSetPayloadLength( LoRaSettings.PayloadLength );
    SX1276LoRaSetLowDatarateOptimize( true );

//#if( ( MODULE_SX1276RF1IAS == 1 ) || ( MODULE_SX1276RF1KAS == 1 ) )
//    if( LoRaSettings.RFFrequency > 860000000 )
//    {
//        SX1276LoRaSetPAOutput( RFLR_PACONFIG_PASELECT_RFO );
//        SX1276LoRaSetPa20dBm( false );
//        LoRaSettings.Power = 14;
//        SX1276LoRaSetRFPower( LoRaSettings.Power );
//    }
//    else
//    {
//        SX1276LoRaSetPAOutput( RFLR_PACONFIG_PASELECT_PABOOST );
//        SX1276LoRaSetPa20dBm( true );
//        LoRaSettings.Power = 20;
//        SX1276LoRaSetRFPower( LoRaSettings.Power );
//    } 
//#elif( MODULE_SX1276RF1JAS == 1 )
    if( LoRaSettings.RFFrequency > 380000000 )  //860000000
    {
        SX1276LoRaSetPAOutput( RFLR_PACONFIG_PASELECT_PABOOST ); //选择 PA_BOOST 管脚输出信号
        SX1276LoRaSetPa20dBm( true );  //最大输出功率
        LoRaSettings.Power = 20;
        SX1276LoRaSetRFPower( LoRaSettings.Power );
    }
    else
    {
        SX1276LoRaSetPAOutput( RFLR_PACONFIG_PASELECT_RFO );
        SX1276LoRaSetPa20dBm( false );
        LoRaSettings.Power = 14;
        SX1276LoRaSetRFPower( LoRaSettings.Power );
    } 
//#endif
	
	// Set the device in Standby Mode
    SX1276LoRaSetOpMode( RFLR_OPMODE_STANDBY );
}

void SX1276LoRaSetDefaults( void )
{
    // REMARK: See SX1276 datasheet for modified default values.

    SX1276Read( REG_LR_VERSION, &SX1276LR->RegVersion );
}

void SX1276LoRaReset( void )
{
    uint32_t startTick;
	
	SX1276SetReset( RADIO_RESET_ON );
    
    // Wait 1ms
    //startTick = GET_TICK_COUNT( );
   // while( ( GET_TICK_COUNT( ) - startTick ) < TICK_RATE_MS( 1 ) );    
    DelayMs(1);

    SX1276SetReset( RADIO_RESET_OFF );
    
    // Wait 6ms
   // startTick = GET_TICK_COUNT( );
   // while( ( GET_TICK_COUNT( ) - startTick ) < TICK_RATE_MS( 6 ) );  
    DelayMs(10);
}
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
