decomen/NXP-K64-gateway/(notices)

Notices in the files:
software/RTU_Terminal/rt-thread/components/net/lwip-1.4.1/src/include/lwip/opt.h:
Copyright (c) 2001-2004 Swedish Institute of Computer Science.
All rights reserved.
software/RTU_Terminal/rt-thread/include/rtdef.h:
This program is free software; you can redistribute it and/or modify
it under the terms of the GNU General Public License as published by
the Free Software Foundation; either version 2 of the License, or
(at your option) any later version.
